raluca-timis/Proiect_Licenta/Documentatie.pdf

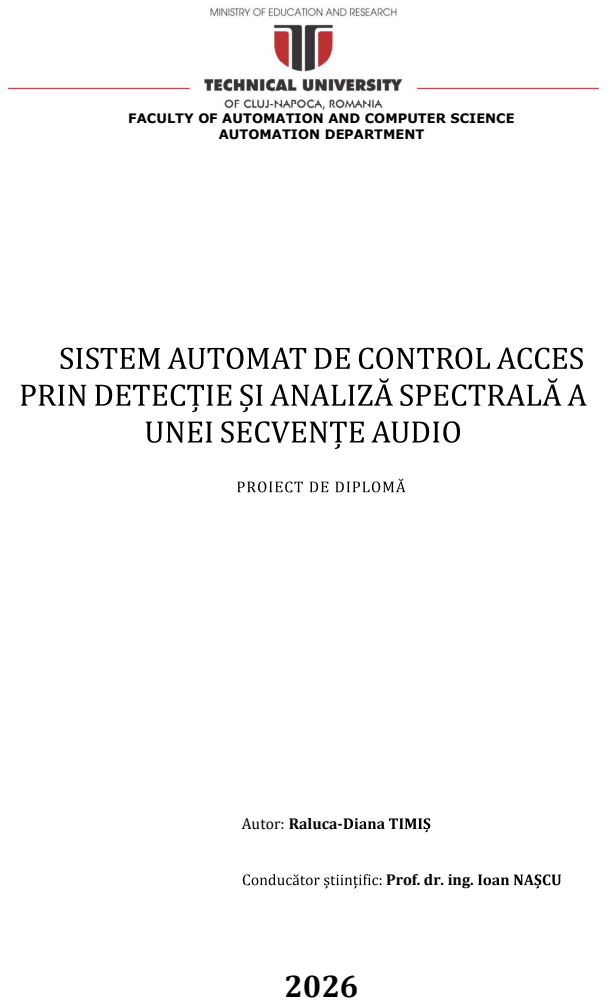
[picture p1: page 1]
AUTOMATION DEPARTMENT; Autor: Raluca-

FACULTY OF AUTOMATION AND COMPUTER SCIENCE

Prof. dr. ing.

# Cuprins

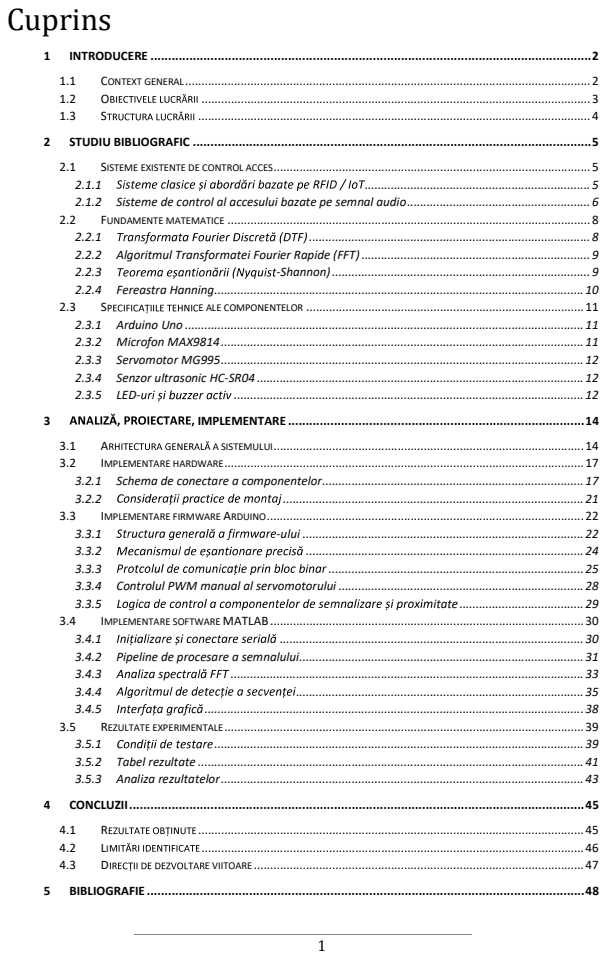
[picture p2: page 2]

Introducere

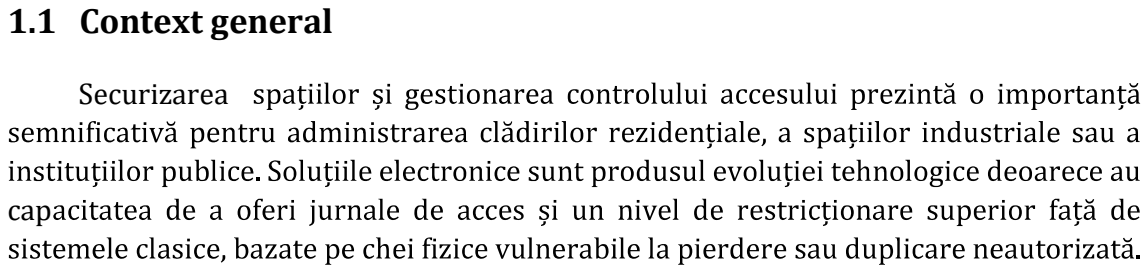
[picture p3: figure]
1.1 Context general; Securizarea; cap
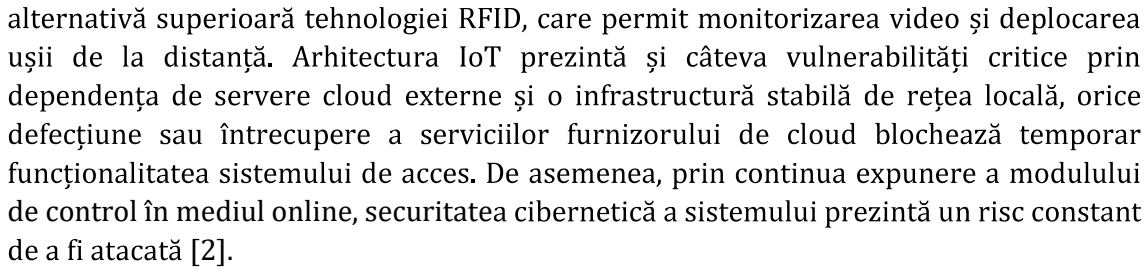
[picture p4: figure]
de control în mediul online, securitate [2].
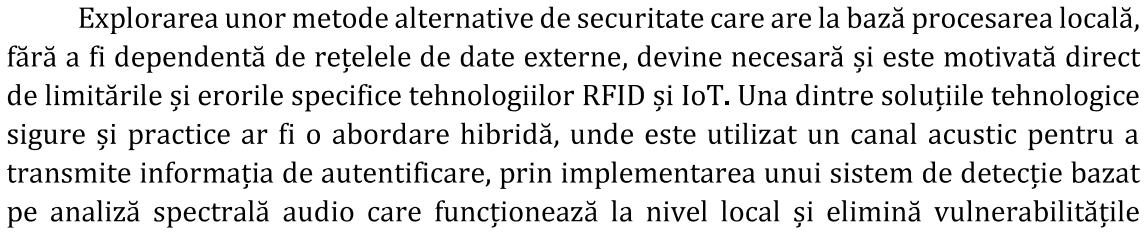
[picture p5: figure]

2

# 1 Introducere

electromagnetice provenite de la obiecte metalice, necriptarea cartelelelor care pot fi

[1]. A urmat integrarea sistemelor Internet of Things,

cauzate de posibilele atacuri cibernetice asociate de conexiunile la internet. Un alt avantaj solid al acest
folosind hardware aflat deja în posesia utilizatorilor, precum difuzoarele integrate ale

dedicate.

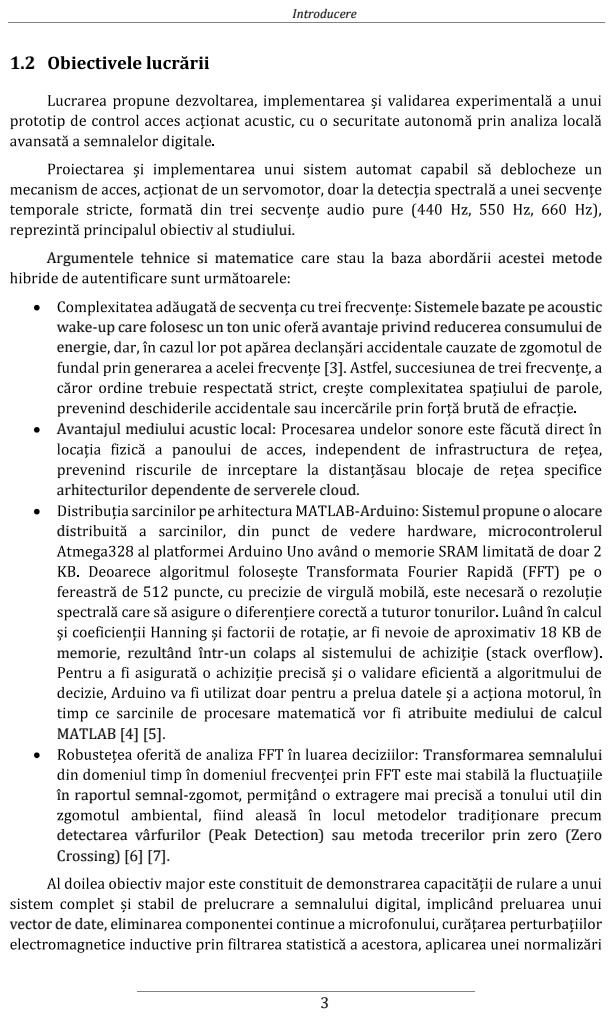
[picture p6: page 4]
Introducere; diului.; Argumentele tehnice si matematice; acestei metode; wake-up care folosesc un ton unic; avantaje privind reducerea consumului de; energie; dis; , microcontrolerul; MATLAB [4] [5].; Transformarea semnalului

Sistemele bazate pe acoustic

Avantajul mediului acustic local:

arhitecturilor dependente de serverele cloud.

-Arduino: Sistemul propune o alocare

memorie, rezultând într-un colaps al sis

atribuite mediului de calcul

în raportul semnal-

detectarea vârfurilor (Peak Detection) sau metoda trecerilor prin zero (Zero
Crossing) [6] [7].

vector de date, elimin

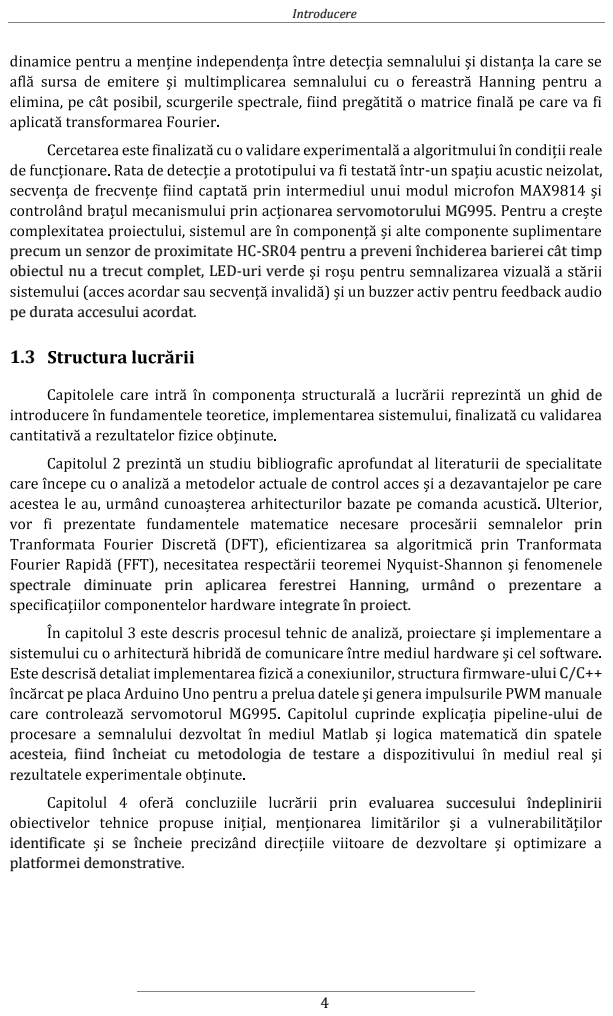
[picture p7: page 5]
Introducere; - a servomotorului MG995.; ghid de; -ului C/C++; -ului de; identificate; se încheie; platformei demonstrative.

precum un senzor de proximitate HC-SR04 pentru a preveni închiderea barierei cât timp
obiectul nu a trecut complet, LED-uri verde

pe durata accesului acordat.

prin - spectrale diminuate prin aplicarea ferestrei Hanning, urmând o prezentare a

egrate în proiect.

acesteia, fiind încheiat cu metodologia de testare
rez

aluarea succesului îndeplinirii

# 2 Studiu bibliografic

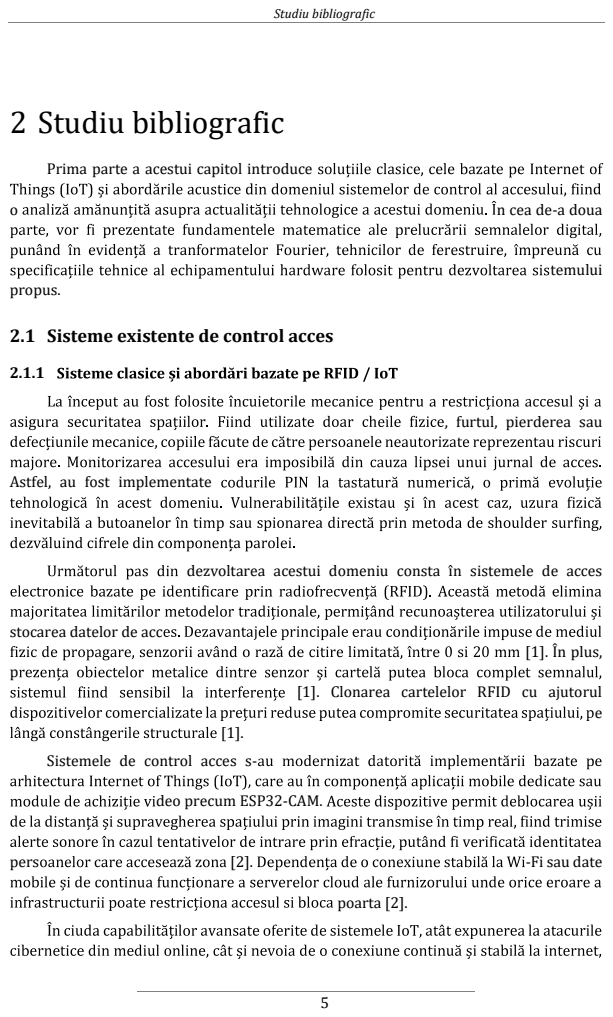
[picture p8: page 6]
Studiu bibliografic; n cea de-a doua; temului; propus.; [1]. În plus,; pers; -Fi sau date; poarta [2].

Prima parte a acestui capitol introduce

2.1 Sisteme existente de control acces

, furtul, pierderea sau

Astfel, au fost implementate

dezvoltarea acestui domeniu consta în sistemele de acces

stocarea datelor de acc

[1]. Clonarea cartelelor RFID cu ajutorul

Sistemele de control acces s-

deo precum ESP32-CAM.

Studiu bibliografic

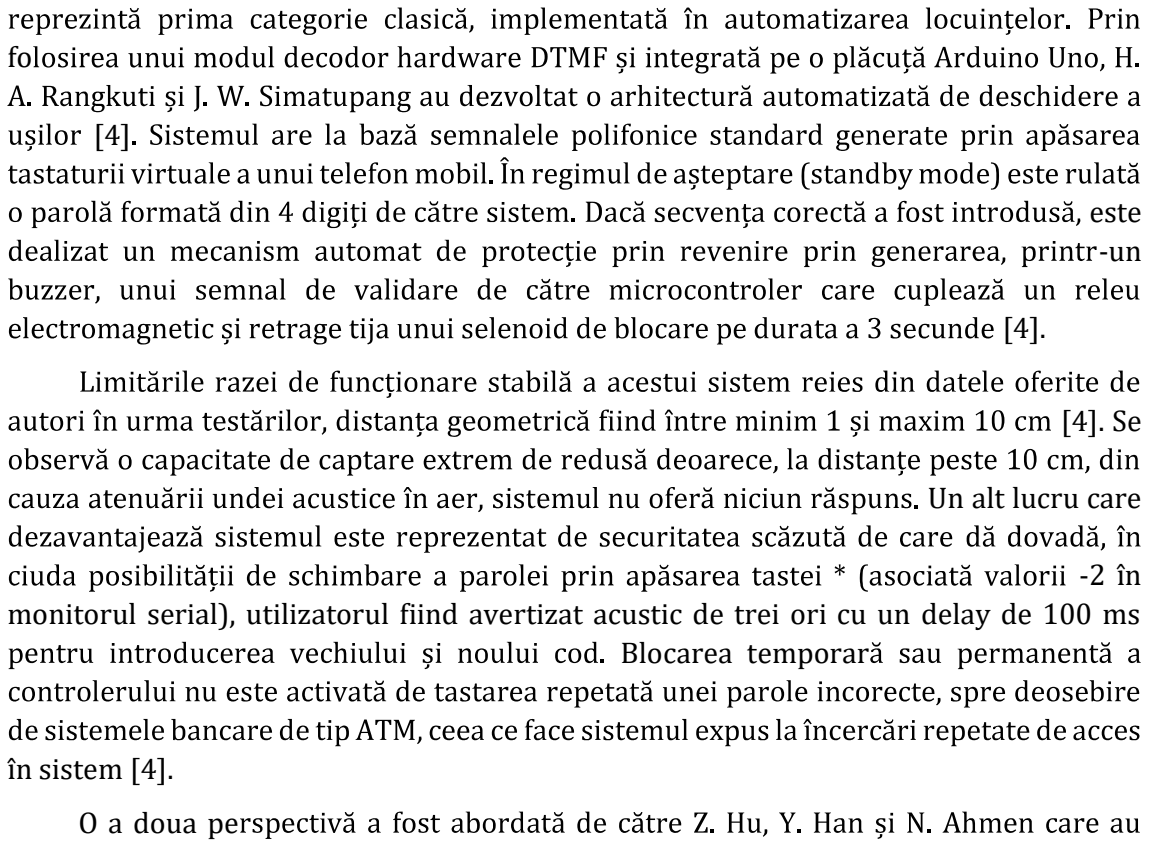
[picture p9: figure]
este -un; Un alt lucru care; Blocarea temporar; în sistem [4].; O a doua pe
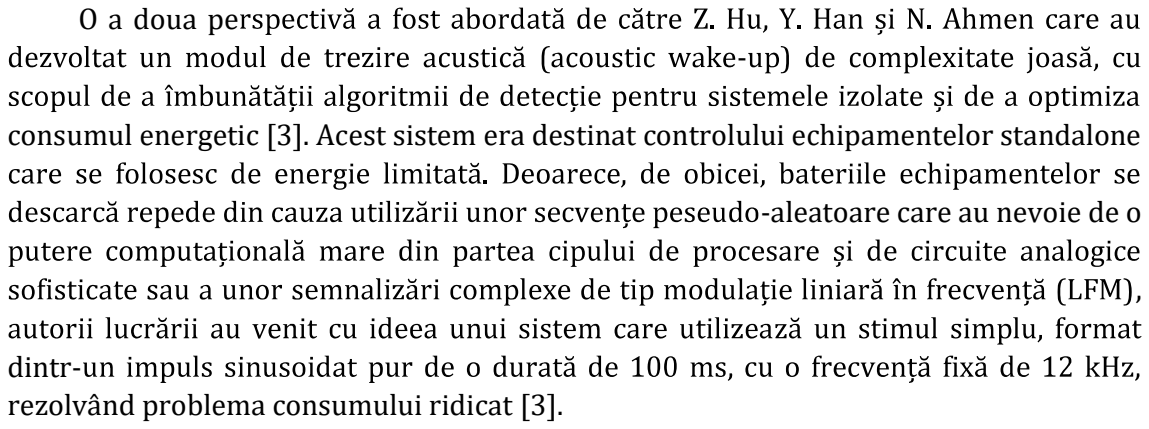
[picture p10: figure]
-aleatoare care au nevoie de o; , dintr-; rezolvând problema consumului ridicat [3].

6

### 2.1.2 Sisteme de control al accesului bazate pe semnal audio

hardware sau matematice sau dezavantaje de design, literatura de specialitate introduce trei mari categorii.
Sistemele de blocare bazate pe tehnologia DTMF (Dual-Tone Multi-Frequency)

monitorul serial), utilizatorul fiind avertizat acustic de trei ori cu un delay de 100 ms

- consumul energetic [3]. Acest sistem era destinat controlului echipamentelor standalone

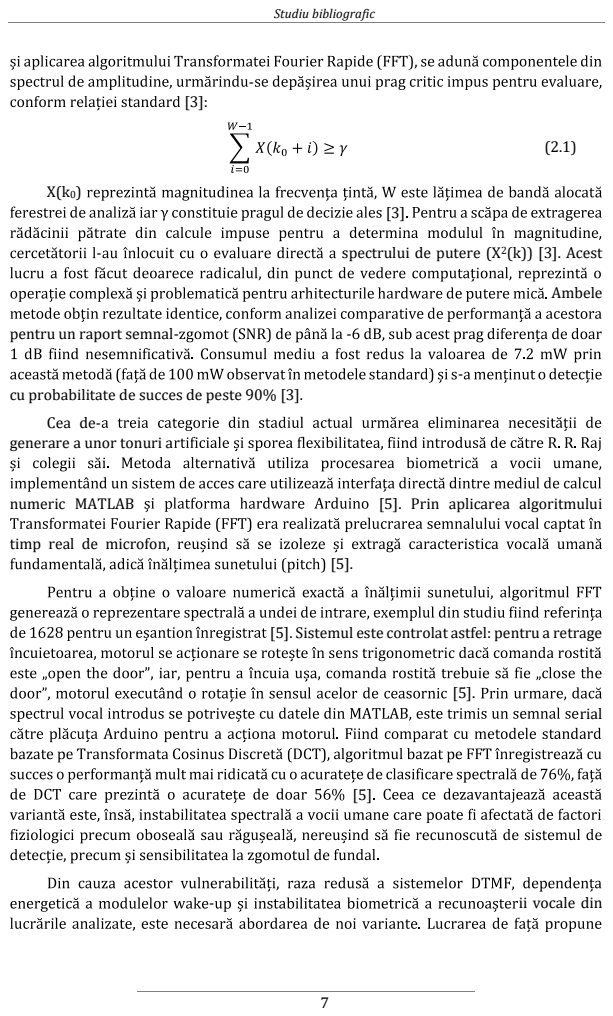
[picture p11: page 8]
Studiu bibliografic; Ambele; pentru un raport semnal-; numeric MATLAB; [5]. Prin aplicarea algoritmului; rial

- spectrului de putere (X²(k)) [3]. Acest

- cu probabilitate de succes de peste 90% [3].

Cea de-
generare a unor tonuri a

timp real de microfon

[5]. Sistemul este controlat astfel: pentru a retrage

- ii vocale din

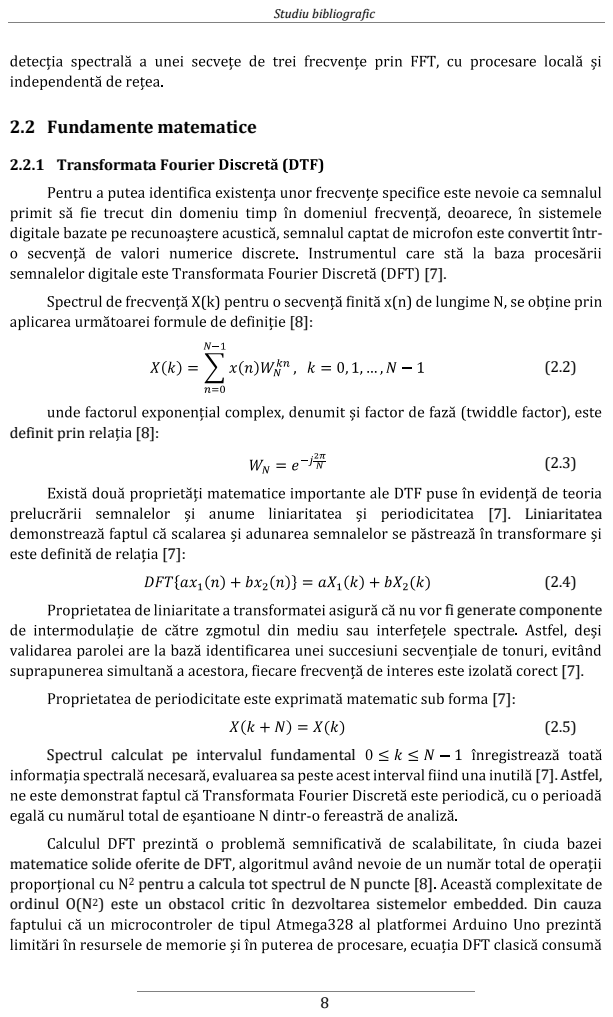
[picture p12: page 9]
Studiu bibliografic; 2.2 Fundamente matematice; 2.2.1 Transformata Fourier; definit prin rel; [7]. Liniaritatea

te convertit într-

fi generate componente

Spectrul calculat pe intervalul fundamental
[7]. Astfel, - matematice solide oferite de DFT

2 pentru a calcula tot spectrul de N puncte [8]

ordinul O(N²) este un obstacol critic în dezvoltarea sistemelor embedded. Din cauza

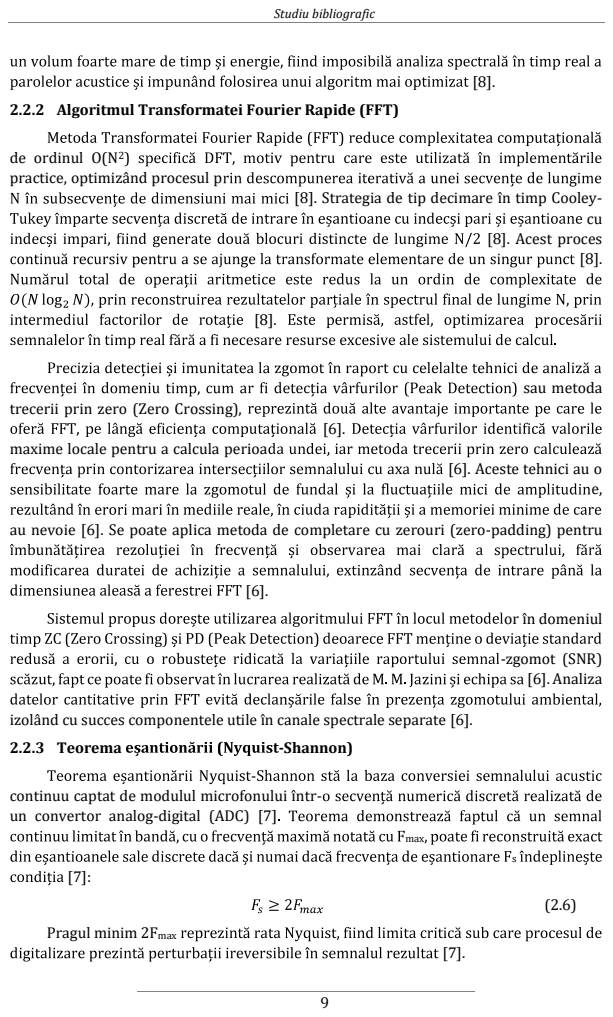
[picture p13: page 10]
Studiu bibliografic; cu [8]. Acest proces [8].; sau metoda; -zgomot (SNR) [6]. Analiza; 2.2.3 Teorema; -Shannon) - continuu captat de modulul microfonului într-; un convertor analog-digital (ADC) [7]; max; Pragul minim 2Fmax

2.2.2 Algoritmul Transformatei Fourier Rapide (FFT)

de ordinul O(N²
practice, optimizând procesul p

[8]. Strategia de tip decimare în timp Cooley-

trecerii prin zero (Zero Crossing),

maxime locale pentru a calcula perioa

[6]. Aceste tehnici au o

au nevoie [6]. Se poate aplica metoda de completare cu zerouri (zero-padding) pentru

or în domeniul

izolând cu succes componentele utile în canale spectrale separate [6].

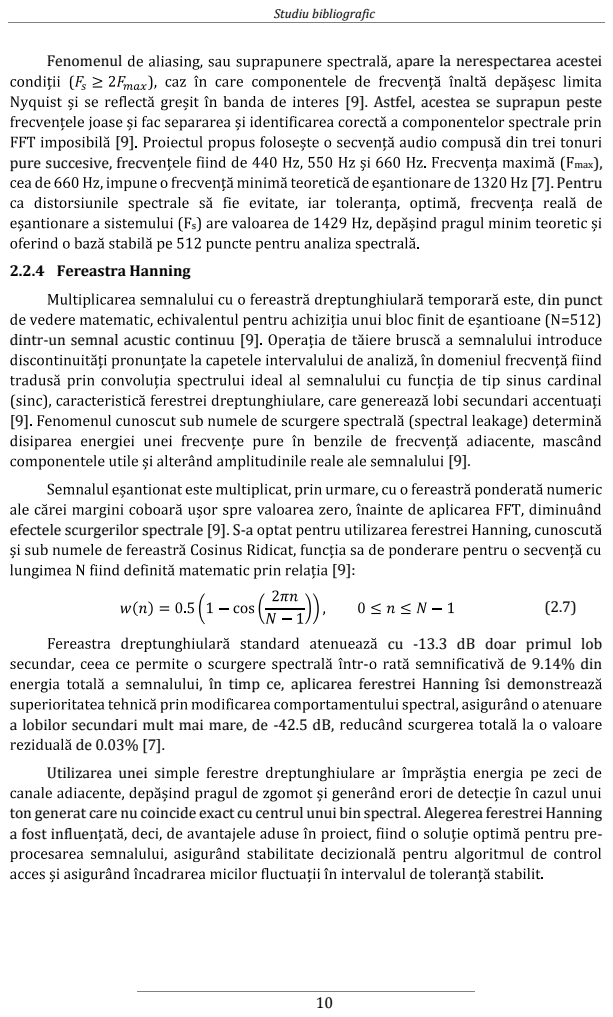
[picture p14: page 11]
Studiu bibliografic; Fenomenul; pare la nerespectarea acestei; pure succesive, frecve; max),; [7]. Pentru; frecve; s 2.2.4 Fereastra Hanning; in punct; cu -13.3 dB doar primul lob -; de 9.14% din; a fost influen

[9]. Astfel, acestea se suprapun peste

dintr-un semnal acustic continuu [9]

efectele scurgerilor spectrale [9]. S-a

, în timp ce, aplicarea ferestrei Hanning îsi demo

a lobilor secundari mult mai mare, de -42.5 dB,

Utilizarea unei si

ton generat care nu coincide exact cu centrul unui bin spectral. Alegerea ferestrei Hanning

Studiu bibliografic

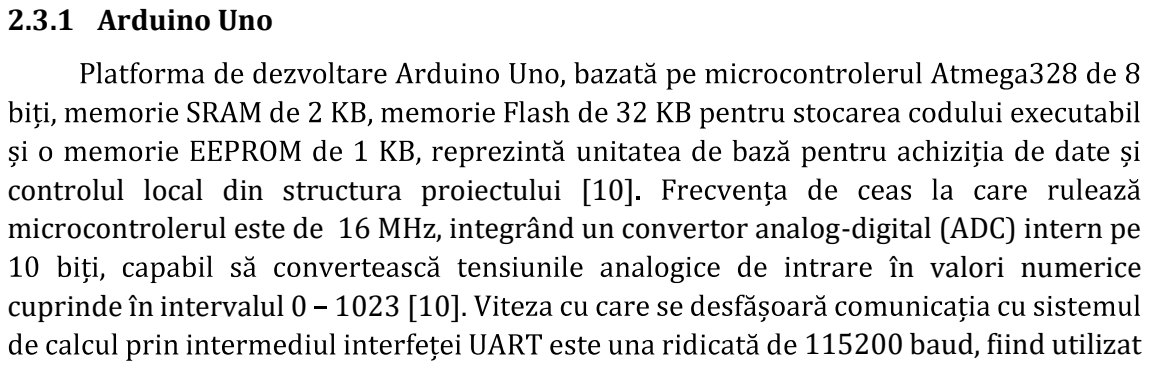
[picture p15: figure]
2.3.1 Arduino Uno; în valori numerice; cuprinde în intervalul 0 1023 [10].; 115200 baud, fiind utilizat
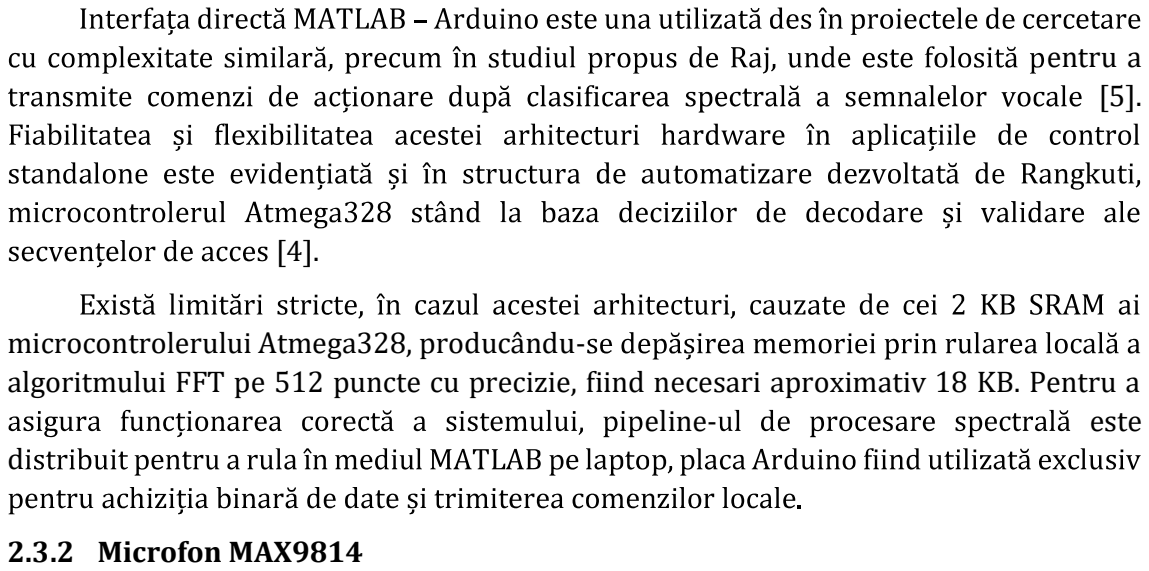
[picture p16: figure]
entru a [5].; microcontrolerului Atmega328, producându-; eline-; este; 2.3.2 Microfon MAX9814
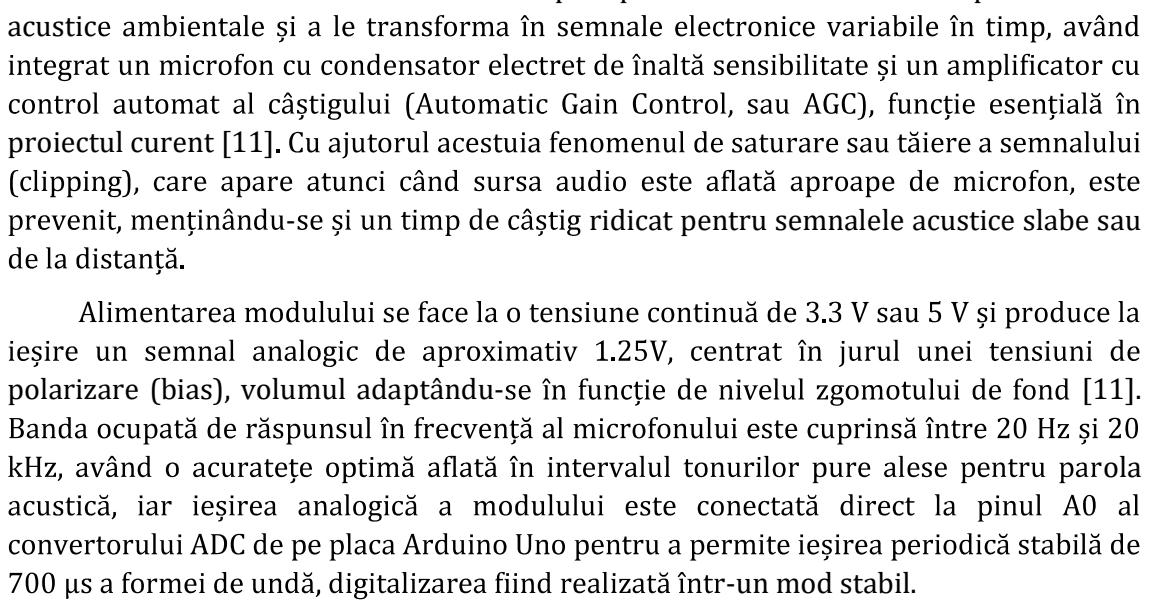
[picture p17: figure]
acustic; proiectul curent [11]; polarizare (bias), volumul adaptându-; ola; -un mod stabil.

11

### 2.3 Specif

controlul local din structura proiectului [10]
microcontrolerul este de 16 MHz, integrând un convertor analog-digital (ADC) intern pe

un protocol de transmisie în bloc binar prin markeri specifici.

algoritmului FFT pe 512 puncte cu precizie, fiind necesari aproximativ 18 KB. Pentru a

Rolul modulului de microfon bazat pe cipul MAX9814 este de a capta a undele

- ridicat pentru semnalele acustice slabe sau

Studiu bibliografic

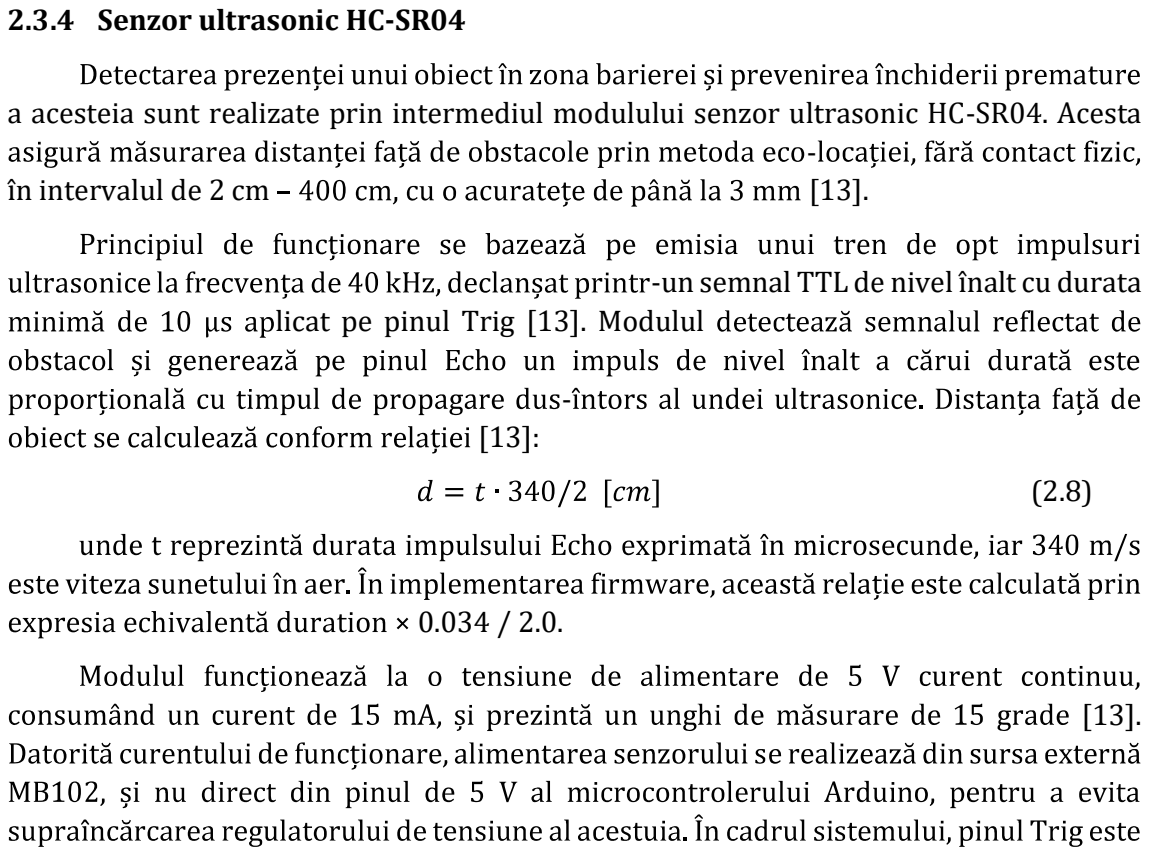
[picture p18: figure]
2.3.4 Senzor ultrasonic HC-SR04; în intervalul de 2 cm; -un semnal TTL de nivel înalt cu durata licat pe pinul Trig [13]. Modulul -

12

### 2.3.3 Servomotor MG995

Caracteristicile principale ale servomotorului de mare cuplu model MG995 care se

ocare la primirea unei parole audio corecte.

sincronizare direct din codul microcontrolerului Arduino, fiind trimis un tren de 50 de pulsuri compuse dintrde 19000 µs. Controlul manual al servomoto
ale
în contact cu magistrala URAT, fiind evitat i un algoritm de control bazat pe un model matematic explicit. Prin urmare, servomotorul este

a acesteia sunt realizate prin intermediul modulului senzor ultrasonic HC-SR04. Acesta -

conectat la pinul digital 5, iar pinul Echo la pinul digital 6 al platformei Arduino Uno.

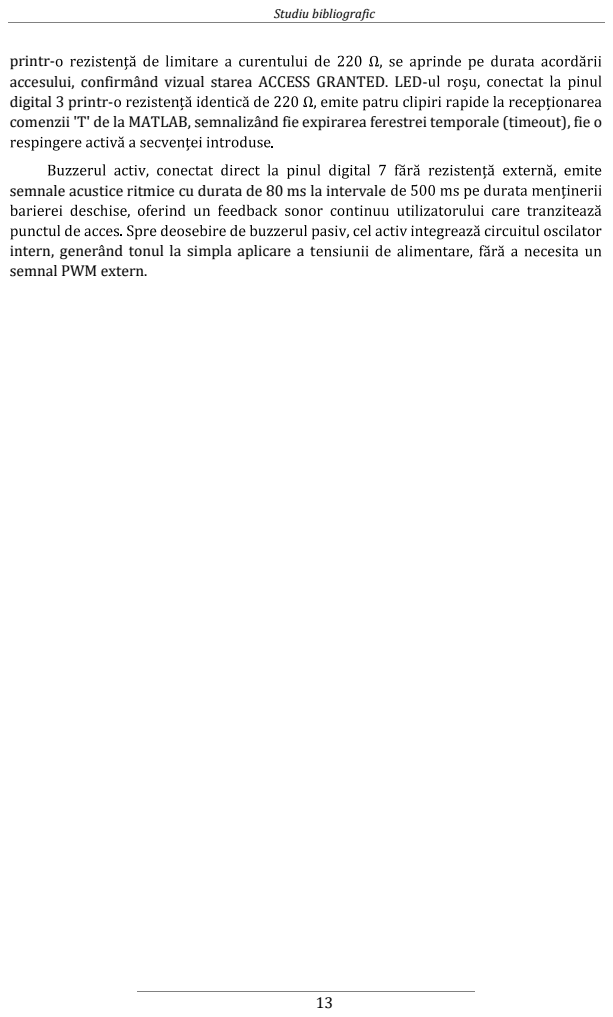
[picture p19: page 14]
Studiu bibliografic

printr-
accesului, confirmând vizual starea ACCESS GRANTED. LED-
digital 3 printr-
comenzii 'T' de la MATLAB, semnalizând fie expirarea ferestrei temporale (timeout), fie o

semnale acustice ritmice cu durata de 80 ms la intervale

intern, generând tonul la simpla aplicare a t
semnal PWM extern.

3

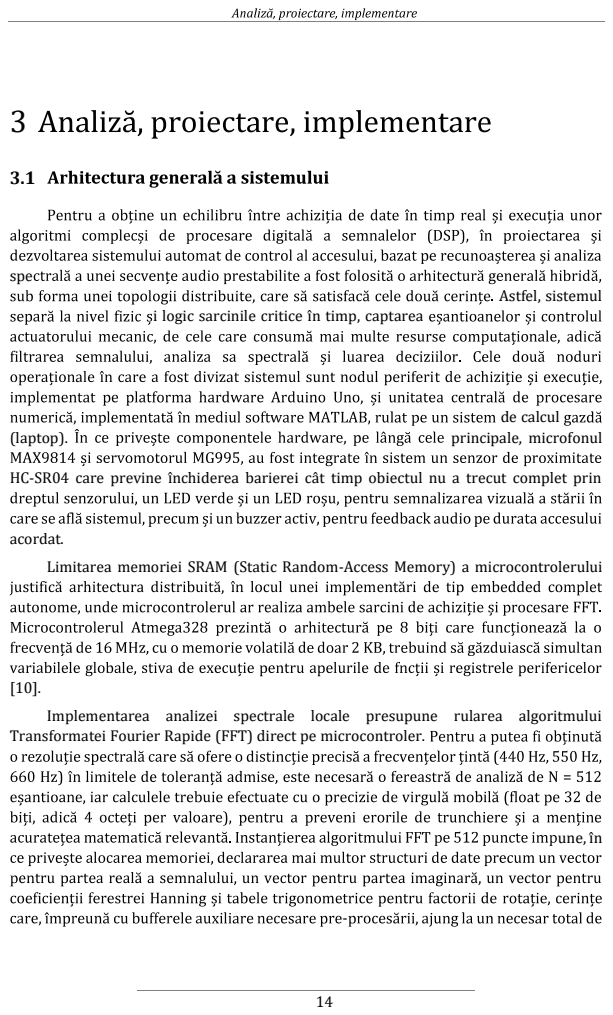
[picture p20: page 15]
spe; Astfel, sistemul; de calcul; (laptop).; principale, microfonul; une, în -

i logic sarcinile critice în timp, captarea

HC-SR04 care previne închiderea barierei cât timp obiectul nu a trecut complet prin

acordat.
Limitarea memoriei SRAM (Static Random-Access Memory) a microcontrolerului

Implementarea analizei spectrale locale presupune rularea algoritmului
Transformatei Fourier Rapide (FFT) direct pe microcontroler.

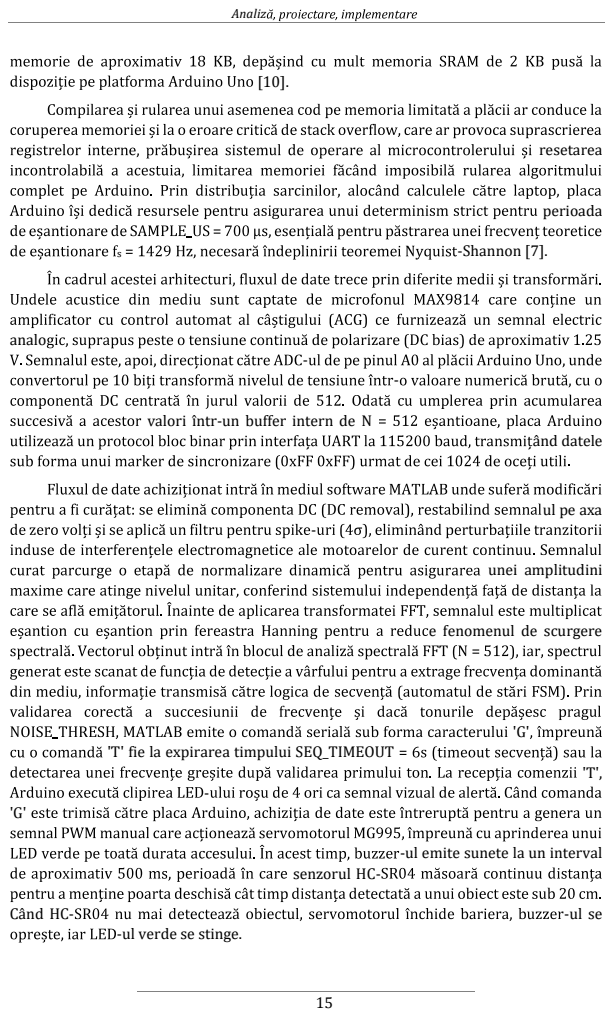
[picture p21: page 16]
Analiz; resetarea; perioada s; -Shannon [7].; analo; ând datele; unei amplitudini; senzorul HC-; Când HC-

valori într-un buffer intern de N

ul pe axa -

e fenomenul de scurgere

'T' fie la expirarea timpului SEQ_TIMEOUT

-ul emite sunete la un interval

-ul verde se stinge.

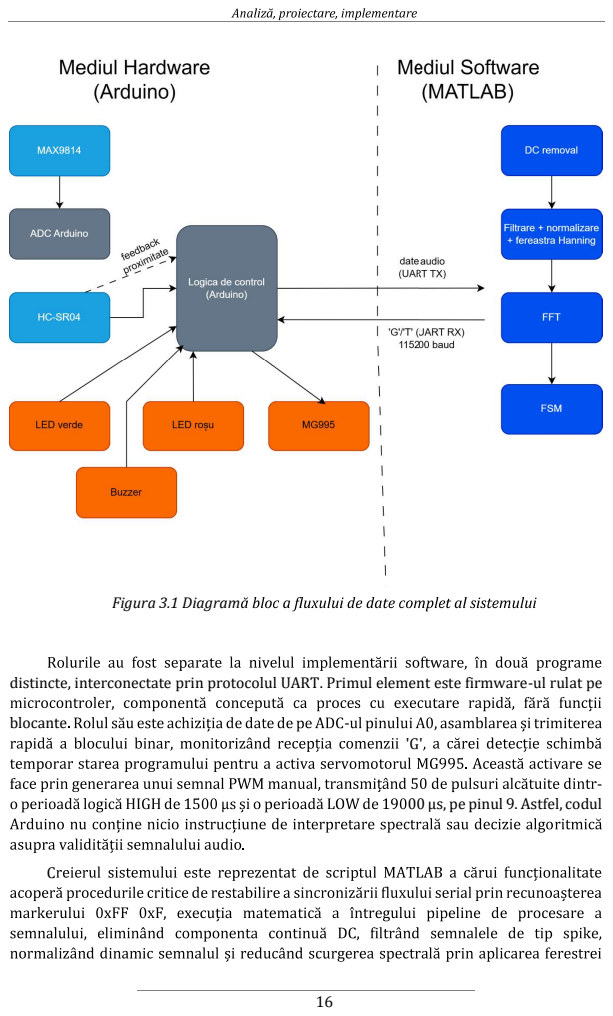
[picture p22: page 17]
blocante; - 00 µs, pe pinul 9. Astfel, codul; Figura 3.1 Diagram

distincte, interconectate prin protocolul UART. Primul element este firmware-ul rulat pe

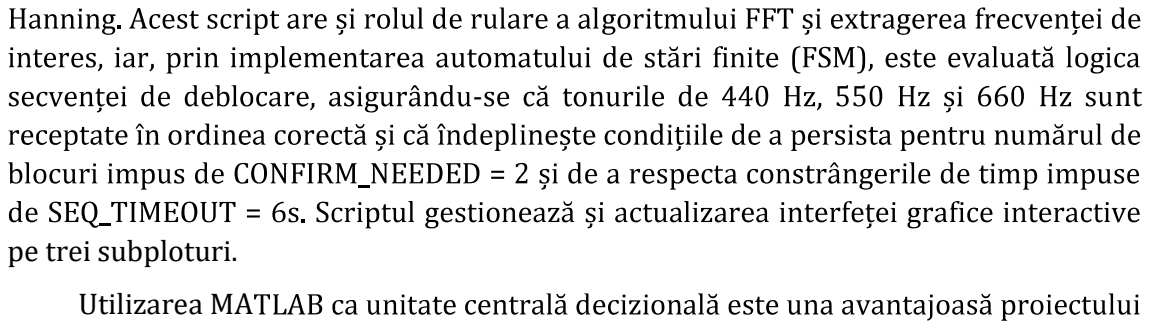
[picture p23: figure]
pe trei subploturi.; Utilizarea MA
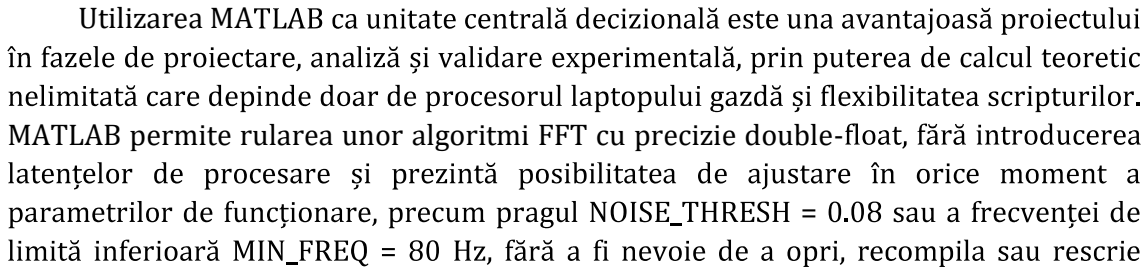
[picture p24: figure]
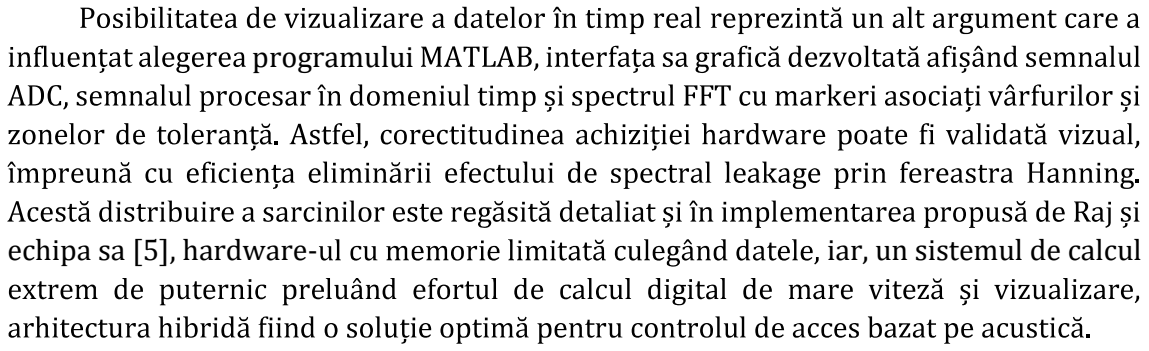
[picture p25: figure]
programului; echipa sa [5], hardware-; iar, un sistemul de calcul
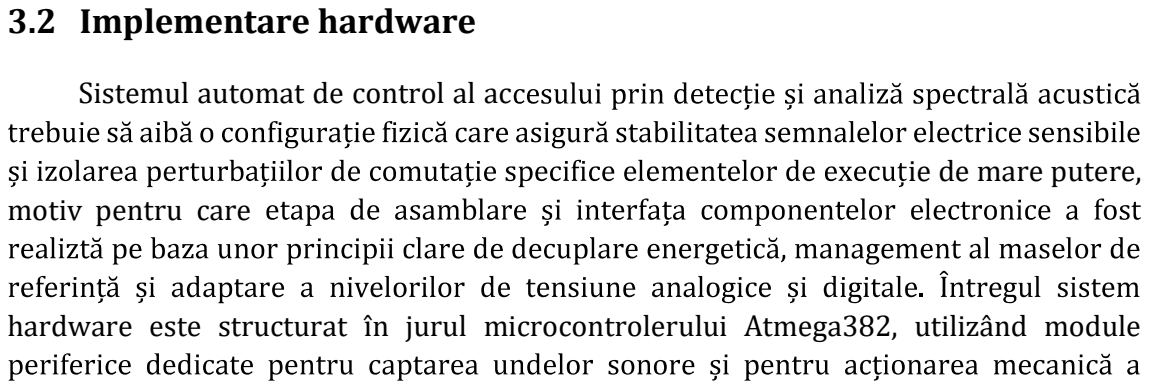
[picture p26: figure]
3.2 Implementare hardware; Sistemul automat de control al ac; ie de mare putere,; motiv pentru care

17

MATLAB permite rularea unor algoritmi FFT cu precizie double-

memoria Flash a microcontrolerului pentru fiecare calibrare.

hardware este structurat în jurul microcontrolerului Atmega382, utilizând module

barierei de acces, conectate direct cu un sistem de calcul numeric prin intermediul unei conexiuni seriale.

### 3.2.1 Schema de conectare a componentelor

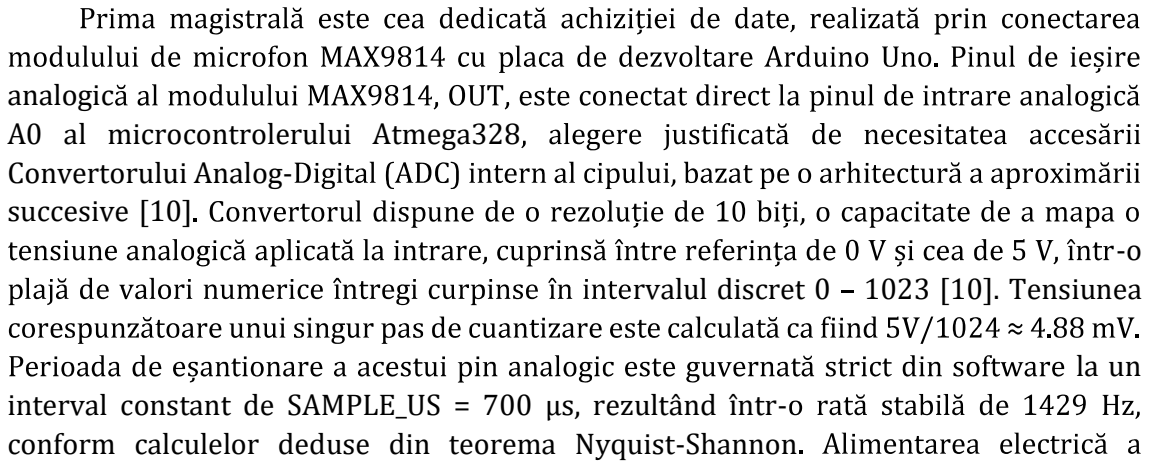
[picture p27: figure]
analogic A0 al microcontrolerului Atmega328 Convertorului Analog- succesive [10]; -o rvalul discret 0 1023 [10]. Tensiunea
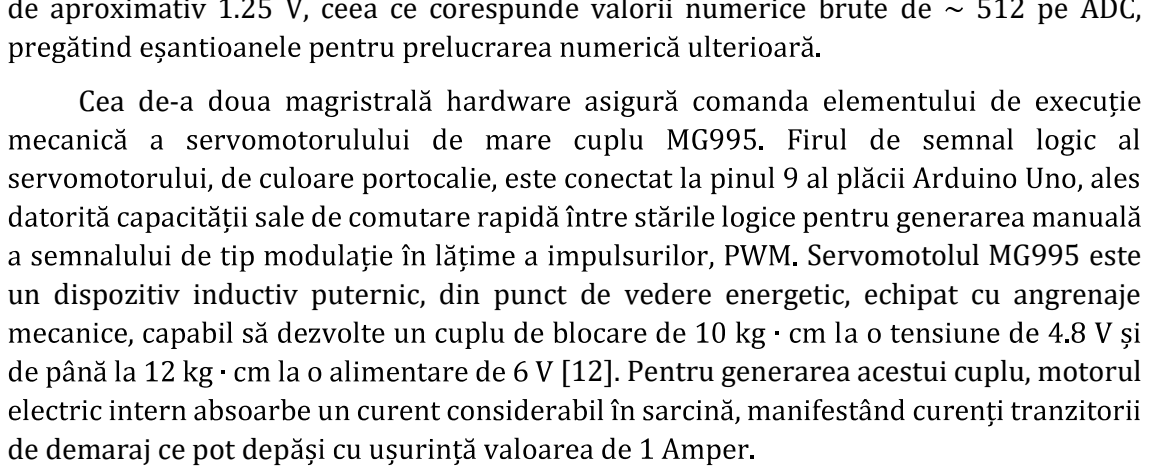
[picture p28: figure]
Cea de-; Servomotolul MG995 este; de demaraj ce pot dep

18

interval constant de SAMPLE_US = 700 µs, rezultând întrconform calculelor deduse din teorema Nyquist-Shannon

Integrarea cipului MAX9814 în acest punct
iei sale i | | Automatic Gain Control).
invers p | ei fa | a unui etaj
utilizatorul ar reda | | , semnalul ar
| | (clipping),
care | | -o într-
ie. Invers, da | - | mare, de exemplu
50 cm, semnalul ar fi prea slab, fiind înecat în zgomotul de cuantizare al ADC-ului. Circuitul

tigul pentru semnalele acustice de intensitate

ire în intervalul optim de conversie al ADC-ului, | [11].
Semnalul util furnizat este centrat în jurul unei tensiuni continue de polarizare (DC bias) de aproximativ 1.25 V, ceea ce corespunde valorii numerice brute de 512 pe ADC,

un dispozitiv inductiv puternic, din punct de vedere energetic, echipat cu angrenaje

[12]. Pentru generarea acestui cuplu, motorul

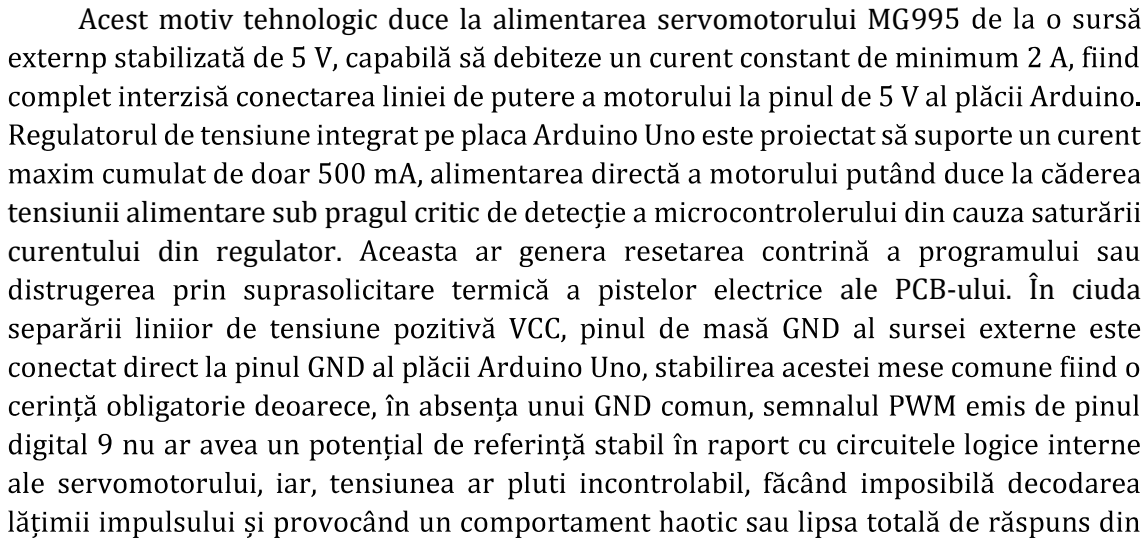
[picture p29: figure]
tensiunii alimentare sub pragul critic curentului din regulator.; ale PCB-ului. În ciuda
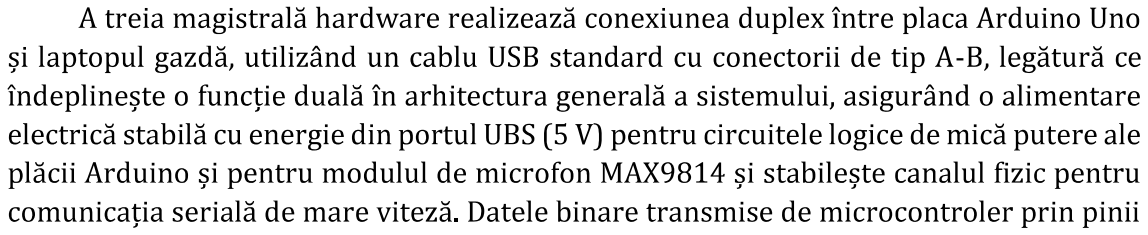
[picture p30: figure]
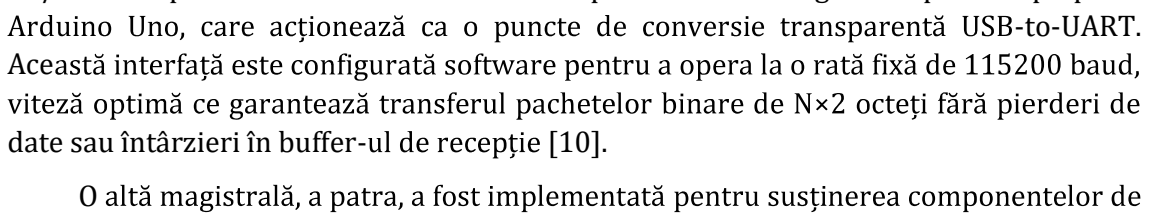
[picture p31: figure]
-to-UART.; Ace; date sau întârzieri în buffer-
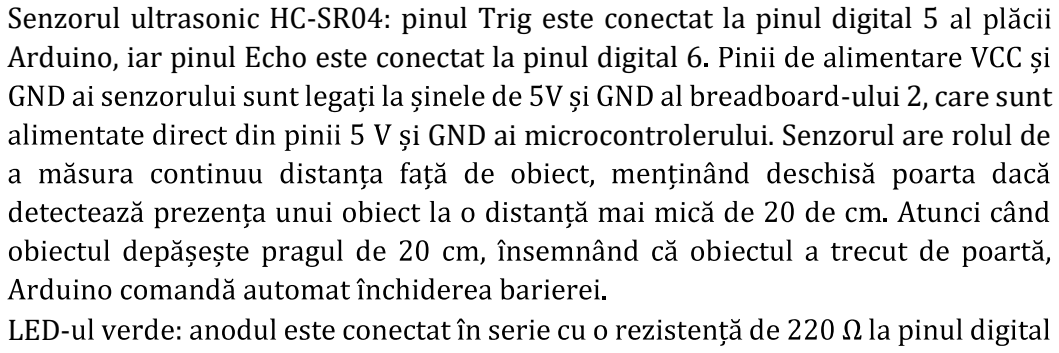
[picture p32: figure]
-ului 2, care sunt; LED-

19

Acest motiv tehnologic duce la alimentarea servomotorului MG99

partea actuatorului [10] [12]. | - TX/RX sunt preluate la nivel hardware de cipul dedicat Atmega16U2 prezent pe placa

Senzorul ultrasonic HC-SR04: pinul Trig este conectat la pinul digital 5 Arduino, iar pinul Echo este conectat la pinul digital 6

i GND ai microcontrolerului. Senzorul are rolul de

acordarea acce | 'G' de la mediul
MATLAB.
LED-

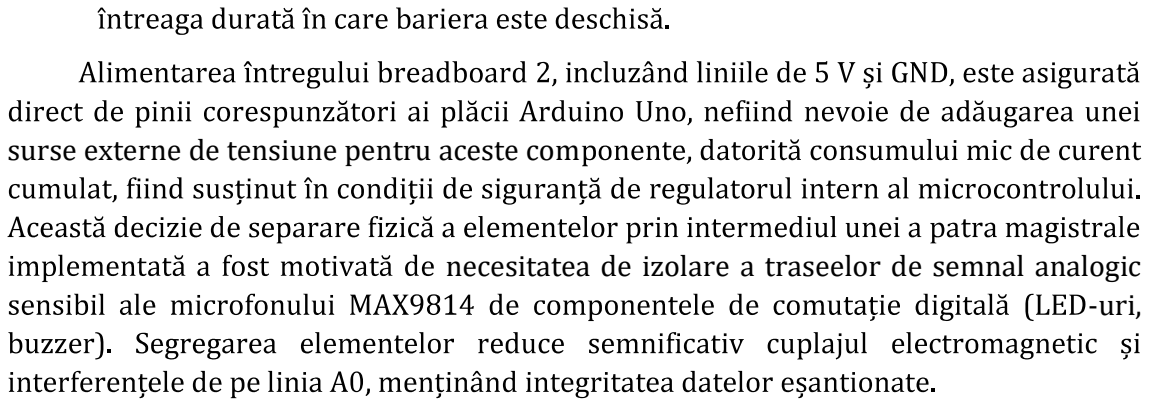
[picture p33: figure]
-uri,
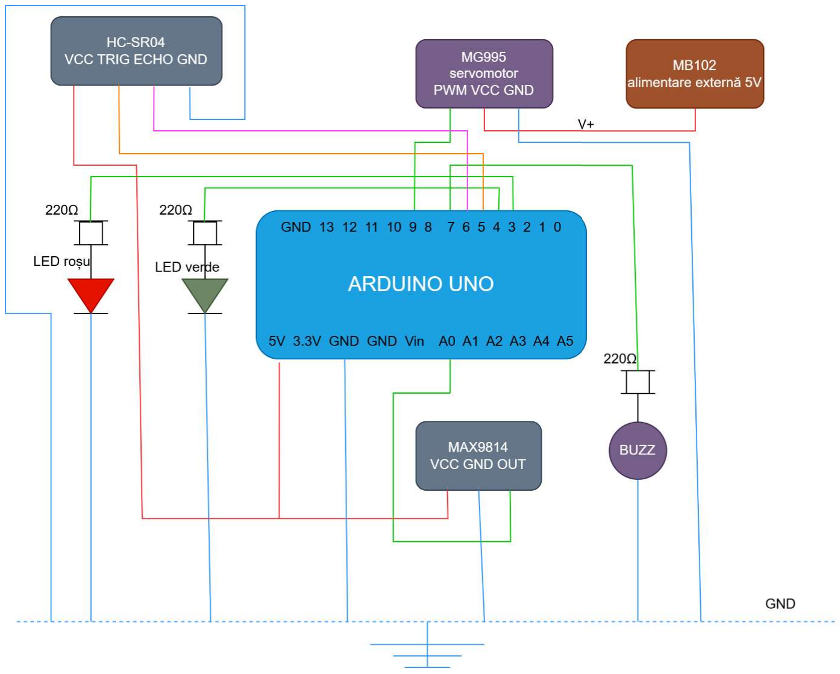
[picture p34: figure]

20

'T'.
Buzzer-ul activ: terminalul pozitiv (+) est | este
conectat la pinul digital 7, terminalul negativ fiind conectat la GND. Dispozitivul emite semnale acustice ritmice, bipuri, la un interval de aproximativ 500 ms, pe

surse externe de tensiune pentru aceste com

necesitatea de izolare a traseelor de semnal analogic

Figura 3.2

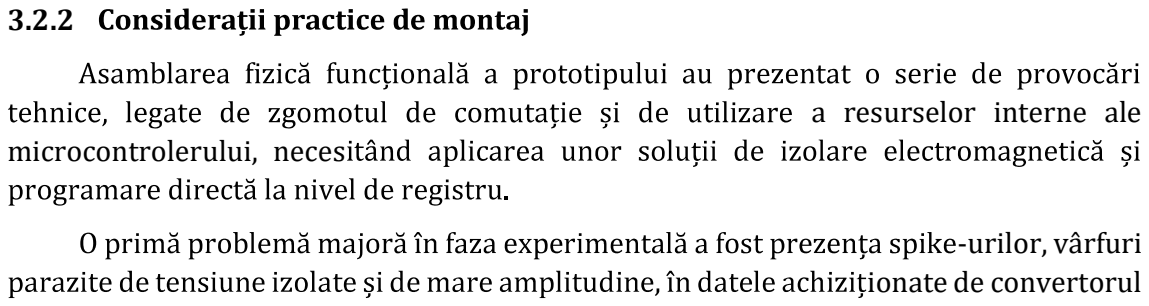
[picture p35: figure]
a resurselor interne ale; microcontrolerului, neces; -urilor, vârfuri ionate de convertorul
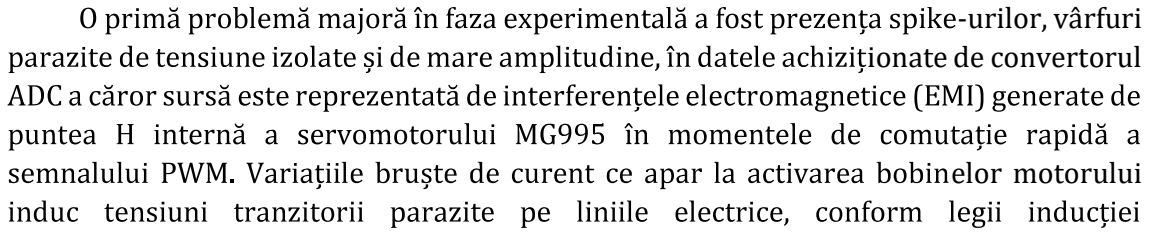
[picture p36: figure]
elor motorului
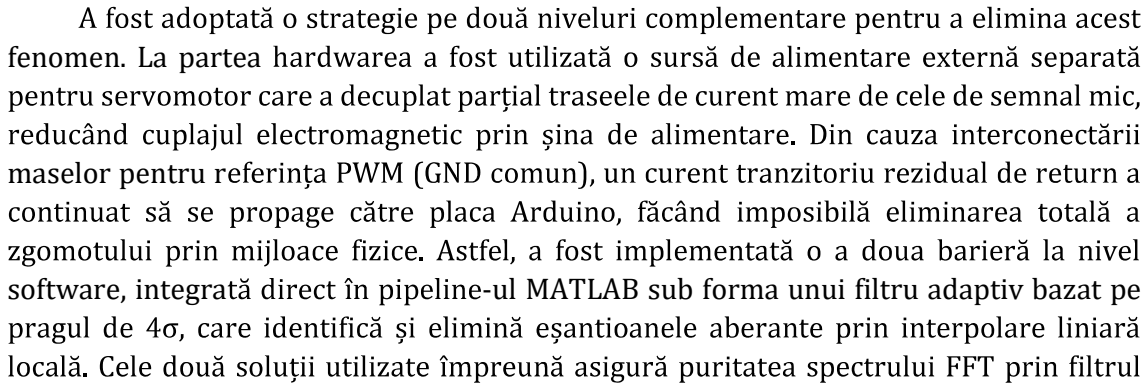
[picture p37: figure]
fenomen. La partea; maselor pentru r
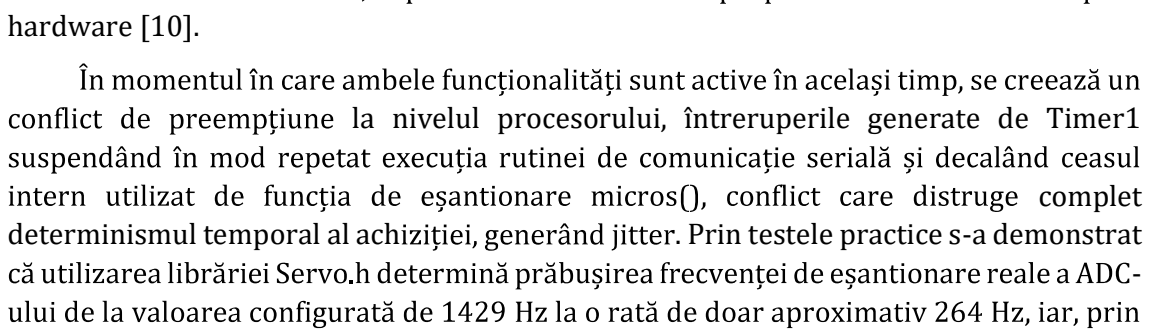
[picture p38: figure]
hardware [10].; complet

21

electromagnetice a lui Faraday, fenomen vizibil direct în mediul MATLAB pe graficul re atingeau
capetele scalei de cuantizare (0 sau 1023), distorsionând analiza Fourier prin
software, integra | -ul MATLAB sub forma unui filtru adaptiv bazat pe

implementat pe software, eliminând complet spike-urile reziduale din buffer, iar partea

[10] [12].

Timer1 al microcontrolerului Atmega328 pentru generarea semnalelor PWM în fundal, bazându-se pe întreruperi software de mare prioritate (Interrupt Service Routines sau
ISR) | - | or binare de

la nivelul procesorului, întreruperile generate de Timer1

determinismul temporal al ach | . Prin testele practice s-a demonstrat -

re, implementare

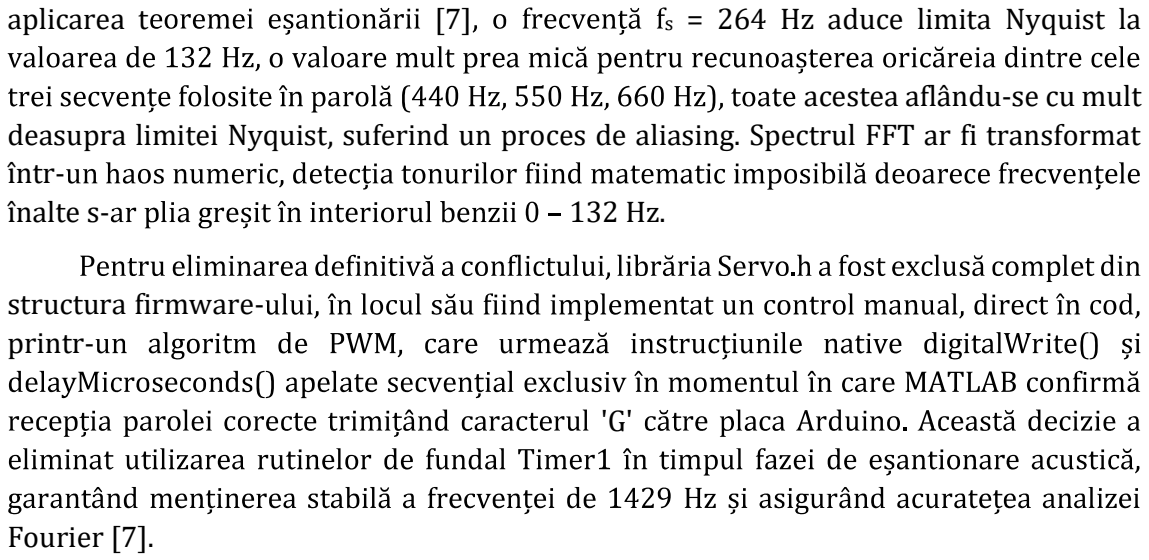
[picture p39: figure]
acestea aflându-se cu mult; într-; înalte s-; structura firmware- printr-; Fourier [7].
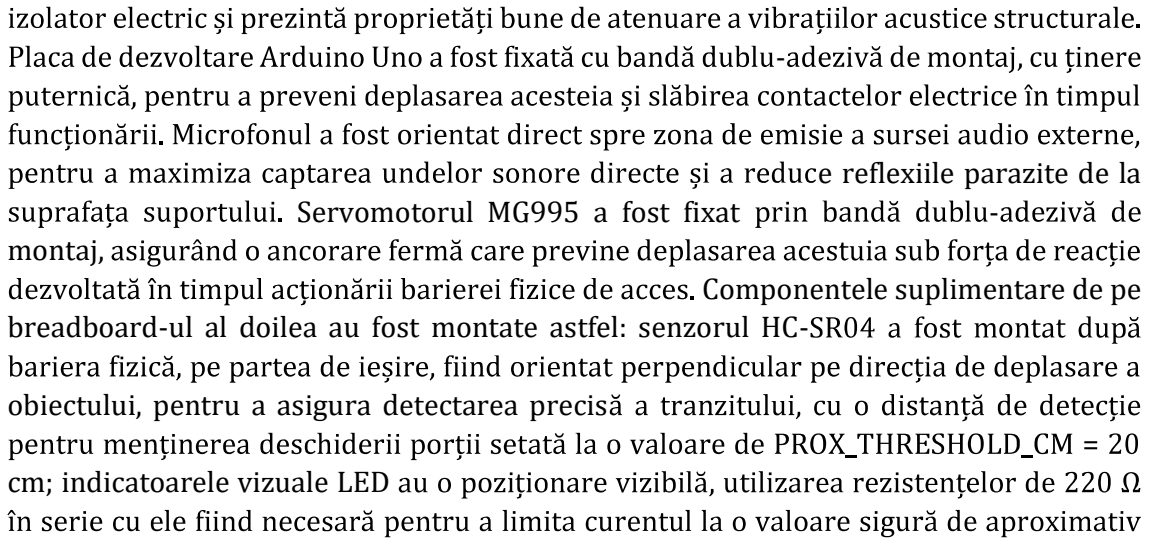
[picture p40: figure]
Servomotorul MG995 a fost fixat; - montaj,; Componentele suplimentare de pe; cm; indicatoarele vizuale LED
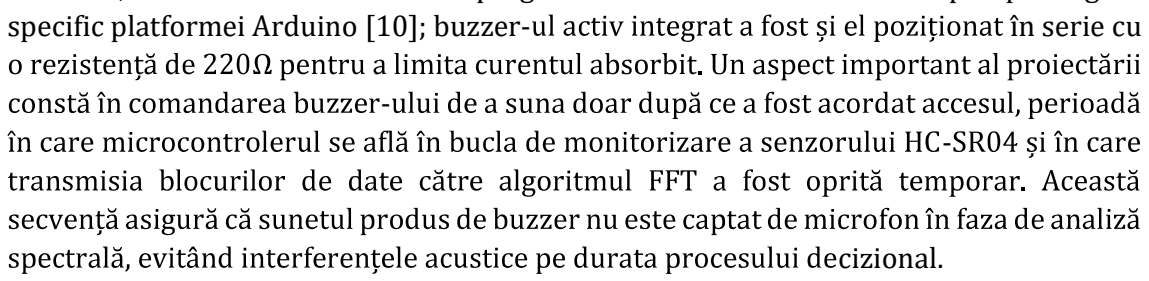
[picture p41: figure]
specific platformei Arduino [10]; buzzer-; în serie cu -; - cizional.

22

aplicarea t | [7] | s = 264 Hz aduce limita Nyquist la

deasupra limitei Nyquist, suferind un proces de aliasing. Spectrul FFT ar fi transformat

Montajul componentelor a fost plasat pe un placaj de lemn, deoarece acesta este un - e reflexiile parazite de la

breadboard-ul al doilea au fost montate astfel: senzorul HC-

obiectului, pentru a asigura detectarea precis

### 13.2 mA, încadrându-se astfel sub pragul maxim admisibil de 40 mA per pin digital

### 3.3 Implementare firmware Arduino

3.3.1 -ului
Software-ul executat de microcontrolerul Atmega328 pe platforma Arduino Uno are

e

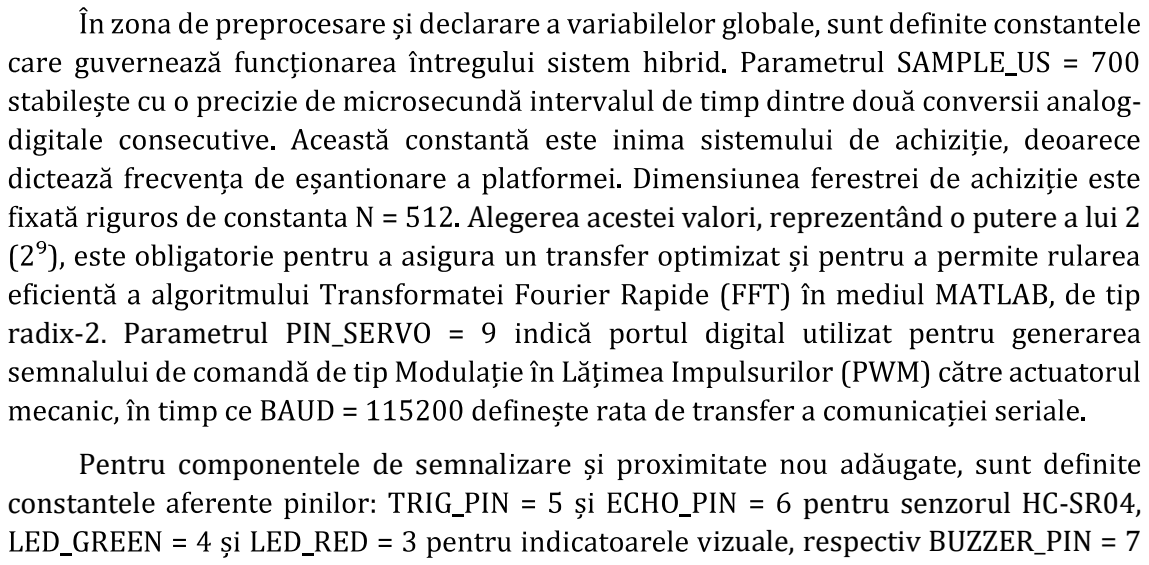
[picture p42: figure]
radix-2. Parametrul PIN_SE; Pentru componentele de semnal; constantel; pentru senzorul HC-SR04,; izuale, respectiv BUZZER_PIN = 7
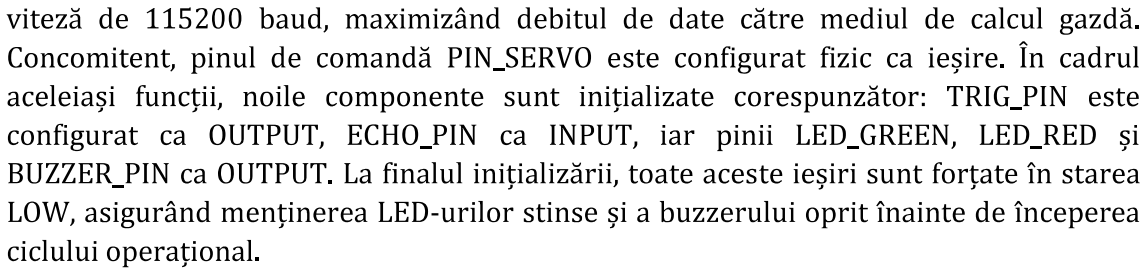
[picture p43: figure]
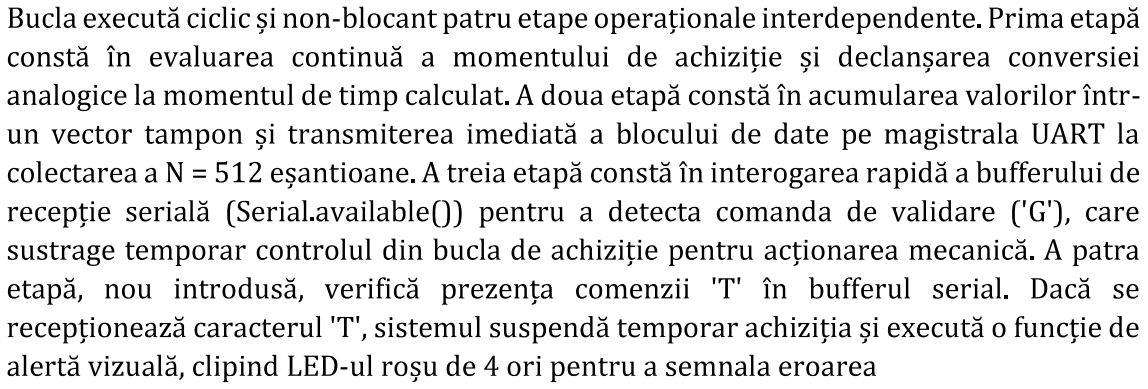
[picture p44: figure]

23

- Alegerea acestei valori, reprezentând o putere a lui 2

a fost definit pragul PROX_THRESHOLD_CM = 20,

alimentare sau la resetarea microc
Serial.begin(115200) pentru a configura hardware-ul UART intern al ATmega328 la o
- simplificate bazate pe un mec

sistemelor de operare în timp real (RTOS) care ar introduce un overhead nejustificat. -

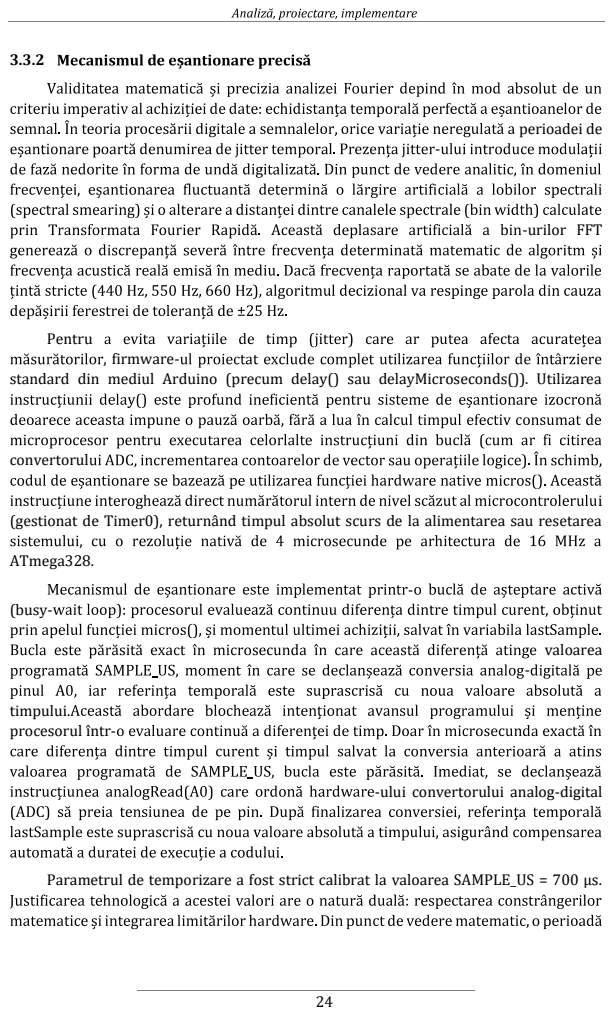
[picture p45: page 25]
perioadei de -; -urilor FFT; Pentru; , firmware-; convertorul; ATmega328.; - (busy-; valoarea - timpului.; procesorul într-

standard din mediul Arduino (precum delay() sau delayMicroseconds()). Utilizarea

(gestionat de Timer0), returnând timpul absolut scurs de la alimentarea sau resetarea

-ului convertorului analog-digital

Parametrul de temporizare a fost strict calibrat la valoarea SAMPLE_US = 700 µs.

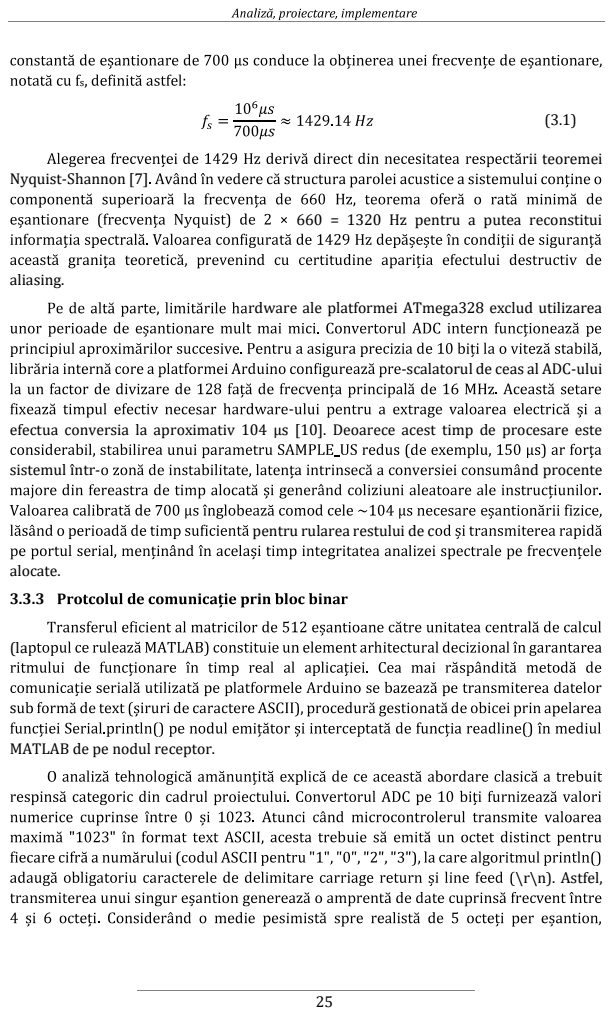
[picture p46: page 26]
ii teoremei; Nyquist-Shannon [7]; aliasing.; sistemul într-; nd procente; alocate.; \r\n). Astfel,

660 = 1320 Hz pentru a putea reconstitui

rdware ale platformei ATmega328 exclud utilizarea

-scalatorul de ceas al ADC-ului - efectua conversia la aproximativ 104 µs [10]. Deoarece acest timp de procesare este

pentru rularea restului de c

MATLAB de pe nodul receptor.

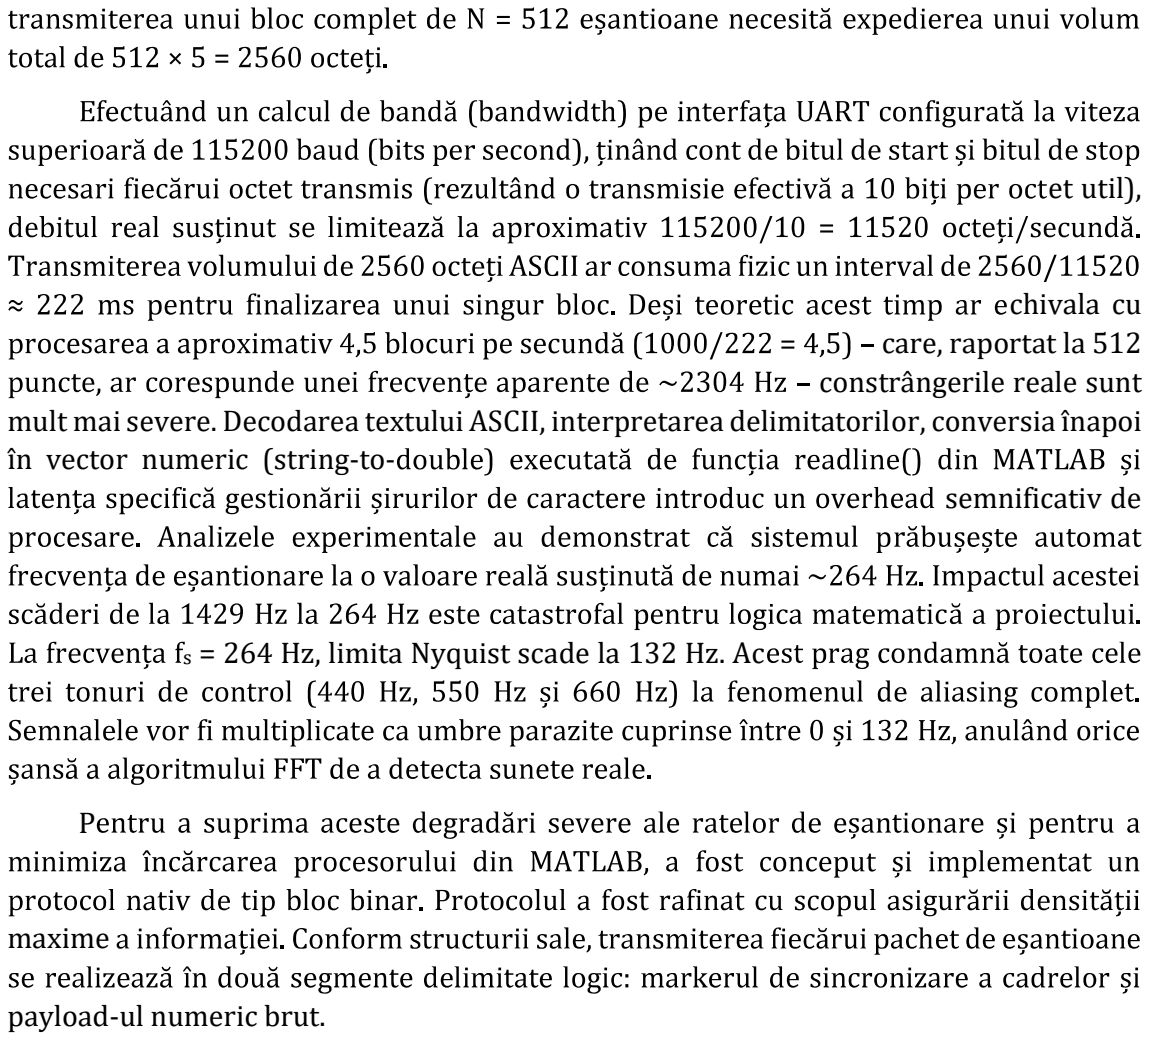
[picture p47: figure]
et util),; chivala cu care, raportat la 512 constrângerile reale sunt; în vector numeric (string-to-; maxime; payload-ul numeric brut.
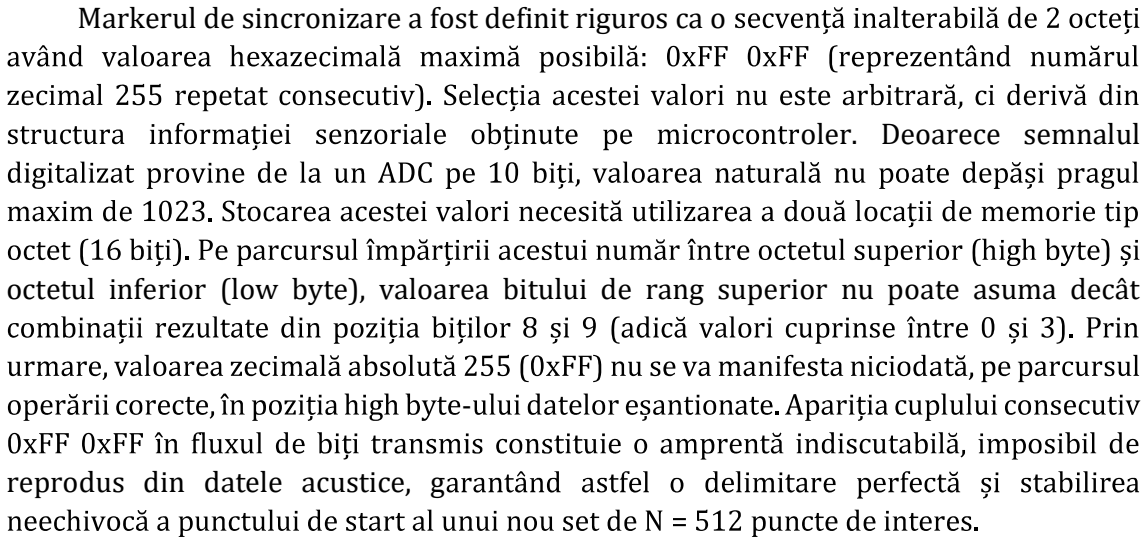
[picture p48: figure]
oler. Deoarece semnalul

26

mult mai severe. Decodarea textului ASCII, interpretarea delimitatorilor, conversia înapoi

semnificativ de s = 264 Hz, limita Nyquist scade la 132 Hz. Ac

Markerul de sincronizare a fost definit riguros ca o

octetul inferior (low byte), valoarea bitului de rang superior nu poate asuma decât - reprodus din datele acustice, g

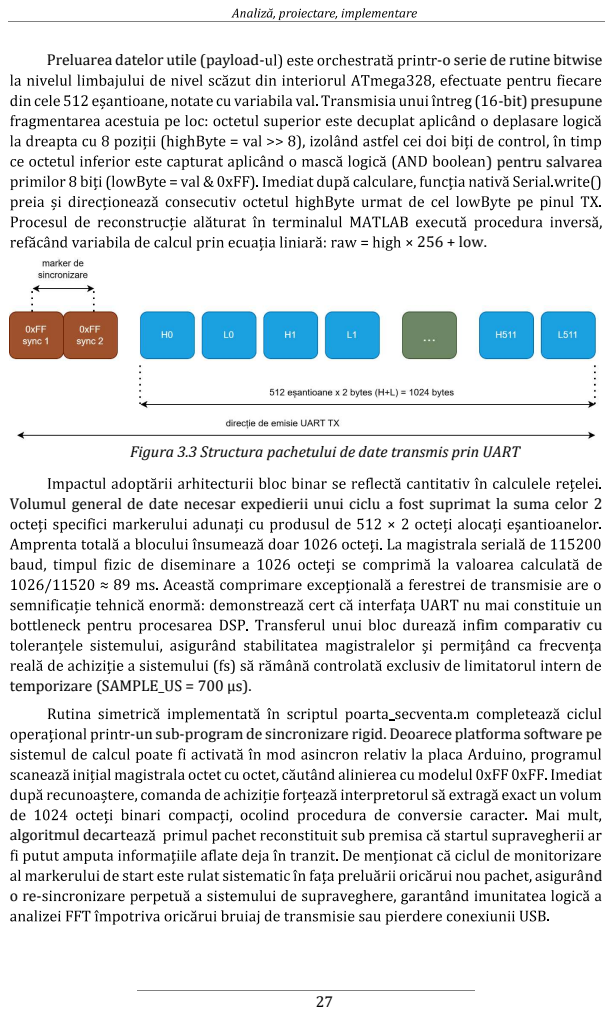
[picture p49: page 28]
Preluarea datelor utile (payload-; -o serie de rutine bitwise; -bit) presupune; ) pentru salvarea; 256 + low.; temporizare (SAMPLE_US = 700 µs).; algoritmul decart

Figura 3.3 Structura pachetului de date transmis prin UART

Volumul general de date necesar expedierii unui ciclu a fost suprimat la suma celor 2

fim comparativ cu

-un sub-program de sincronizare rigid. Deoarece platforma software pe

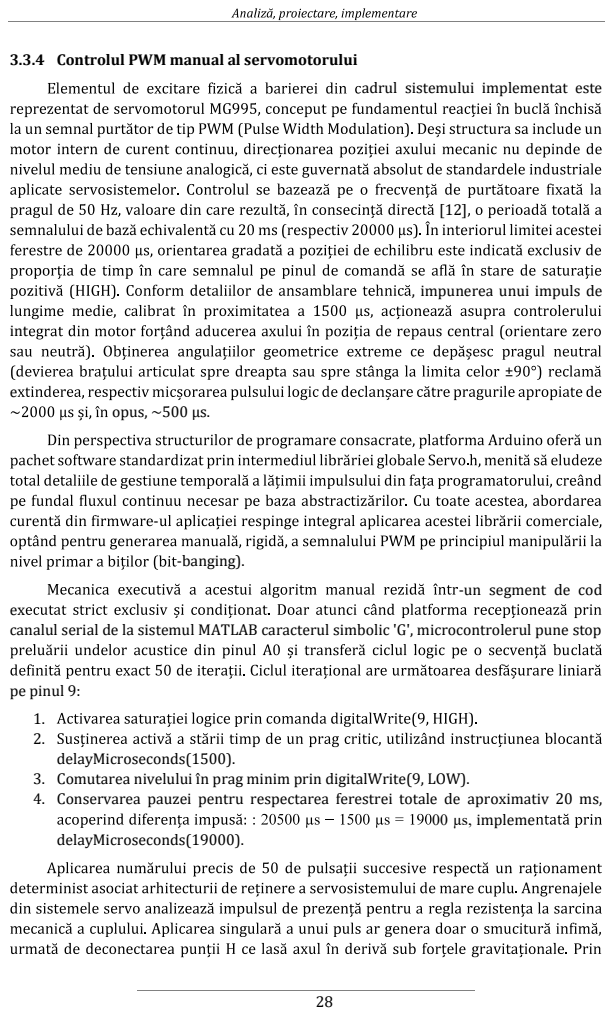
[picture p50: page 29]
int; opus, ~500 µs.; -banging).; 00 µs, impleme; delayMicroseconds(19000).

3.3.4 Controlul PWM manual al servomotorului

adrul sistemului implementat este

, impunerea unui impuls de

-un segment de cod

canalul serial de la sistemul MATLAB caracterul simbolic 'G', microcontrolerul pune stop

pe pinul 9:
delayMicroseconds(1500).
3. Comutarea nivelului în prag minim prin digitalWrite(9, LOW).
4. Conservarea pauzei pentru respectarea ferestrei totale de aproximativ 20 ms,

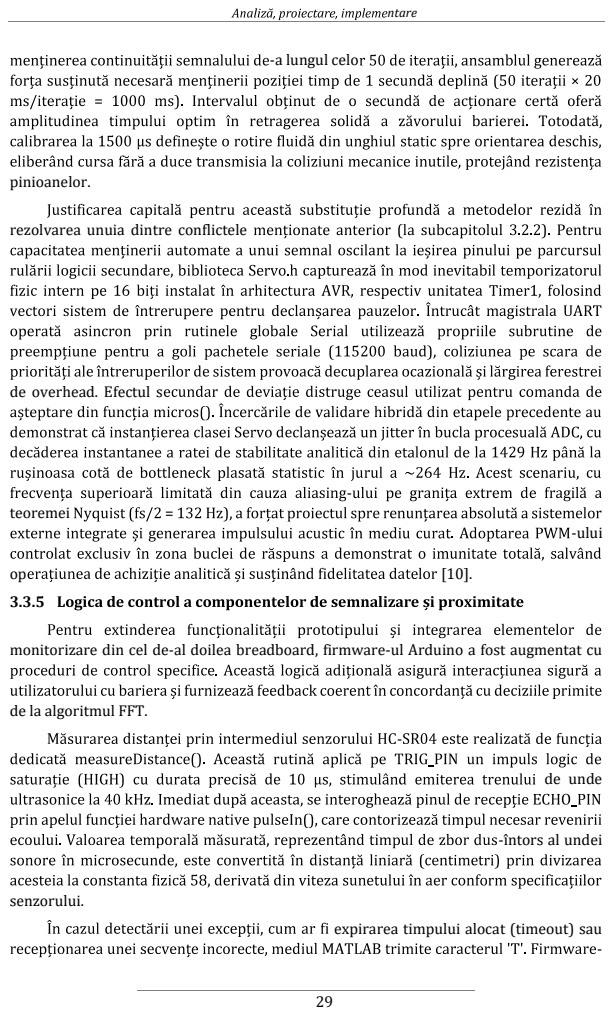
[picture p51: page 30]
ntare; -a lungul celo; pinioanelor.; - teoremei; -ului; de la algoritmul FFT.; de unde; senzorului.

rezolvarea unuia dintre conflictele

de overhead. Efectul s

monitorizare din cel de-al doilea breadboard, firmware-ul Arduino a fost augmentat cu

-întors al undei

expirarea timpului alocat (timeout) sau -

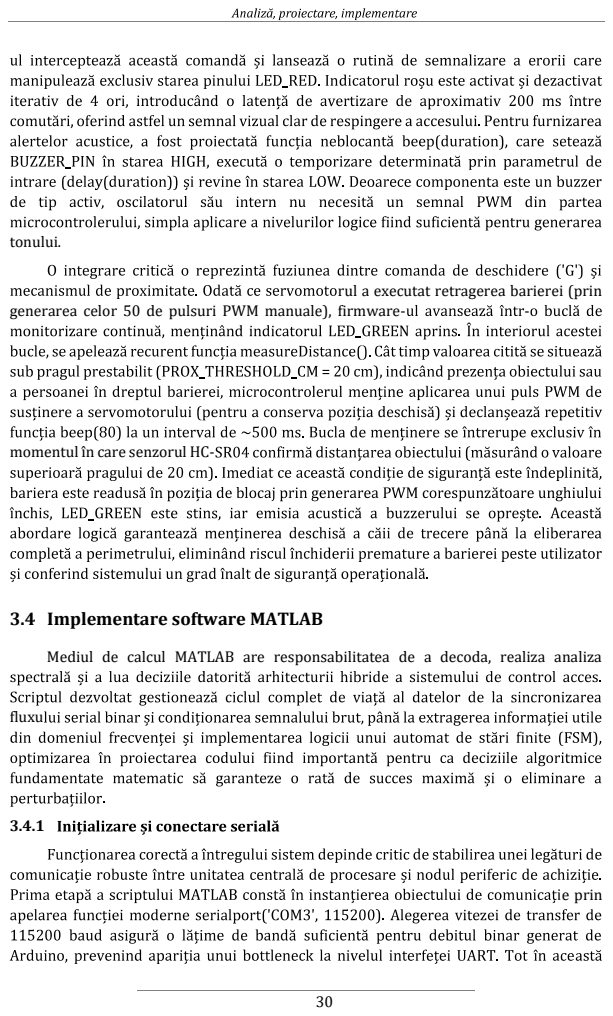
[picture p52: page 31]
tonului.; generarea celor 50 de pulsuri PWM manuale), firmware-; - momentul în care senzorul HC-; fluxu; e prin

rul a executat retragerea barierei (prin

3.4 Implementare software MATLAB

Mediul de calcul MATLAB are responsabilitatea de a decoda, realiza analiza

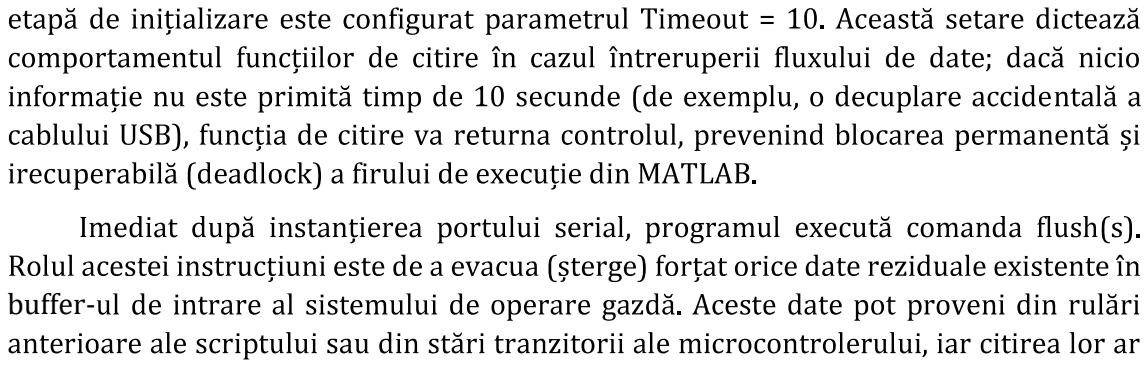
[picture p53: figure]
buffer-
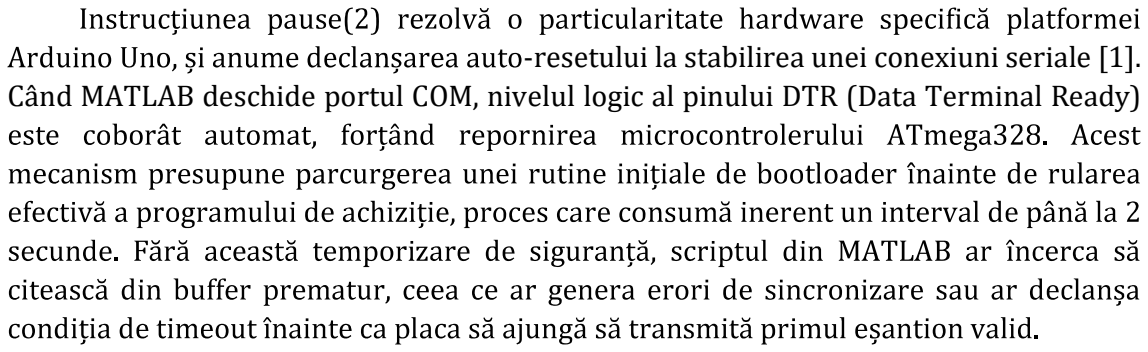
[picture p54: figure]
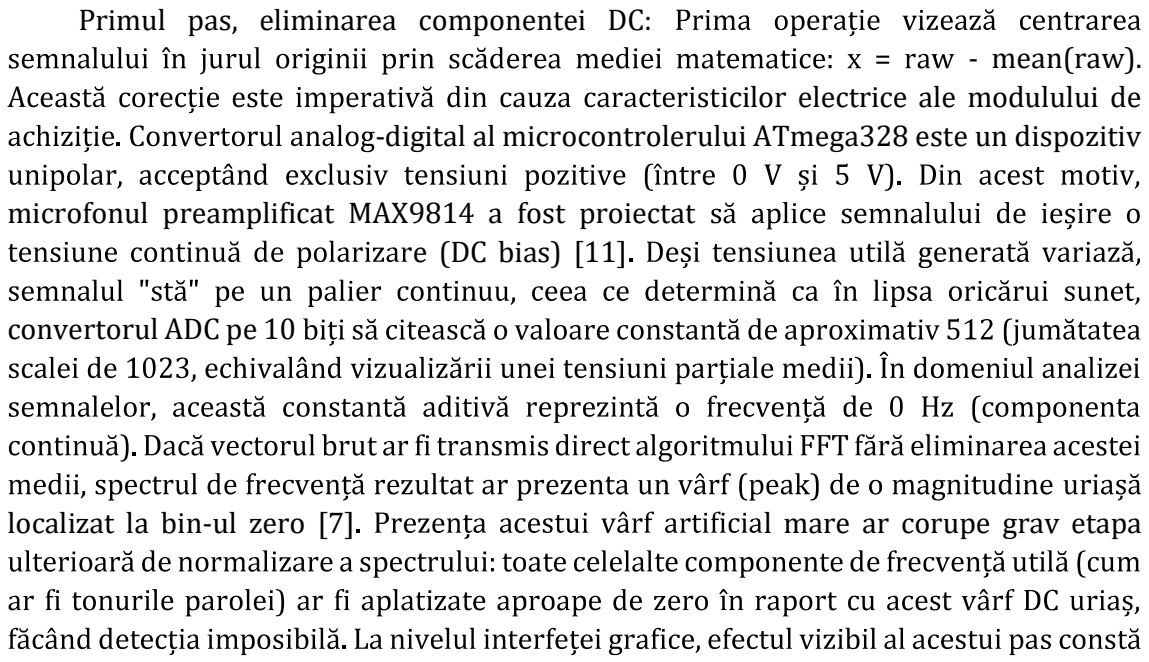
[picture p55: figure]
Primul pas, eliminarea componentei DC:; - mean(raw). icilor electrice ale modulului de; e (DC bias) [11]; convertorul ADC pe 10

31

corupe procesul de sincronizare a cadrelor binare.

-resetului la stabilirea unei conexiuni seriale [1]. Când MATLAB deschide portul COM, nivelul logic al pinului DTR (Data Terminal Ready)

### 3.4.2 Pipeline de procesare a semnalului

raw. În a
anomalii induse de mediul electronic. Pentru a extrage spectrul pur al semnalului,
vectorul raw este trecut printr- | it

-digital al microcontrolerului ATmega328 este un dispozitiv

microfonul preamplificat MAX9814 a fost proiectat

localizat la bin-ul zero [7] | l mare ar corupe grav etapa

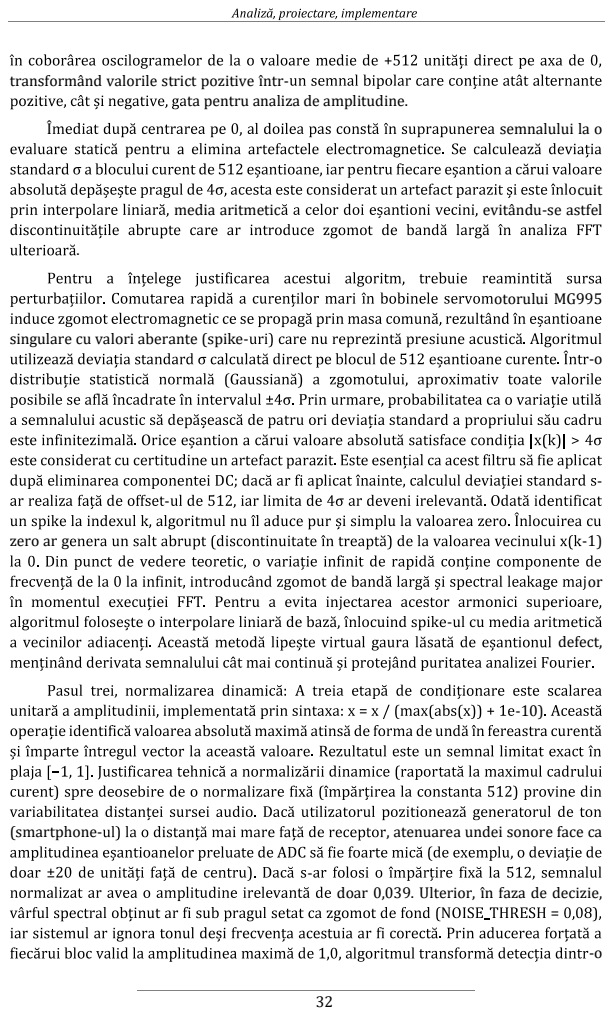
[picture p56: page 33]
semnalului la o; cuit; media aritmetic; evitându-se astfel; otorului MG995; - zero ar g; defect,; (smartphone-; , atenuarea undei sonore face ca -

transformând valorile strict pozitive într-

ta pentru analiza de amplitudine.

singulare cu valori aberante (spike-

doar 0,039. Ulterior, în faza de decizie,

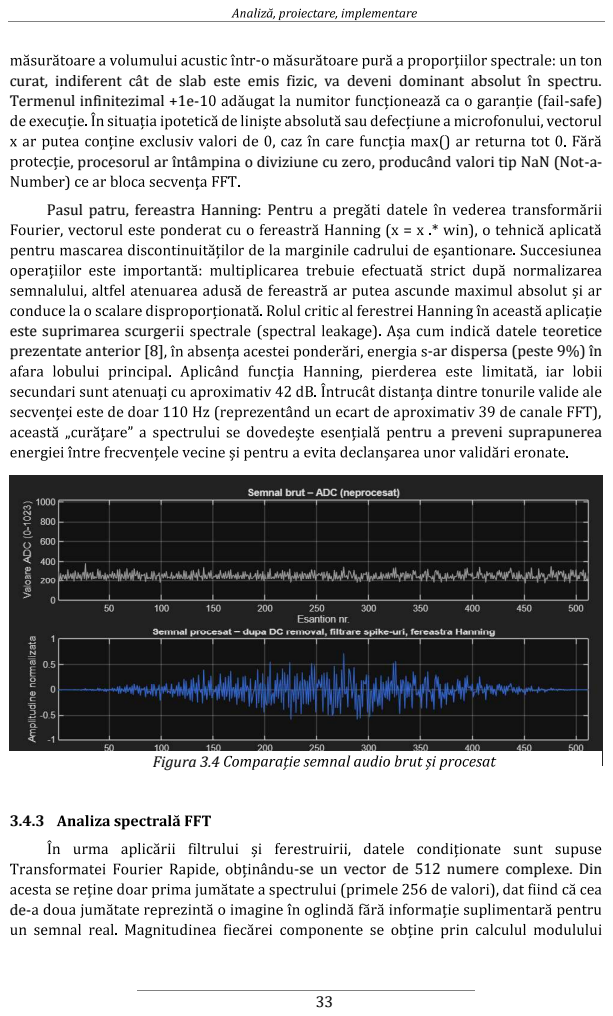
[picture p57: page 34]
Termenul infinitezimal +1e-; -safe); este suprimarea scurger; eoretice; prezentate anterior [8]; -ar dispersa (peste 9%) în; Figura 3.4

- curat, indiferent cât de slab este emis fizic, va deveni dominant absolut în spectru.

ie, procesorul ar întâmpina o diviziune cu zero, producând valori tip NaN (Not-a-

Pasul patru, fereastra Hanning: Pentr

tru a preveni suprapunerea

-se un vector de 512 numere complexe. Din

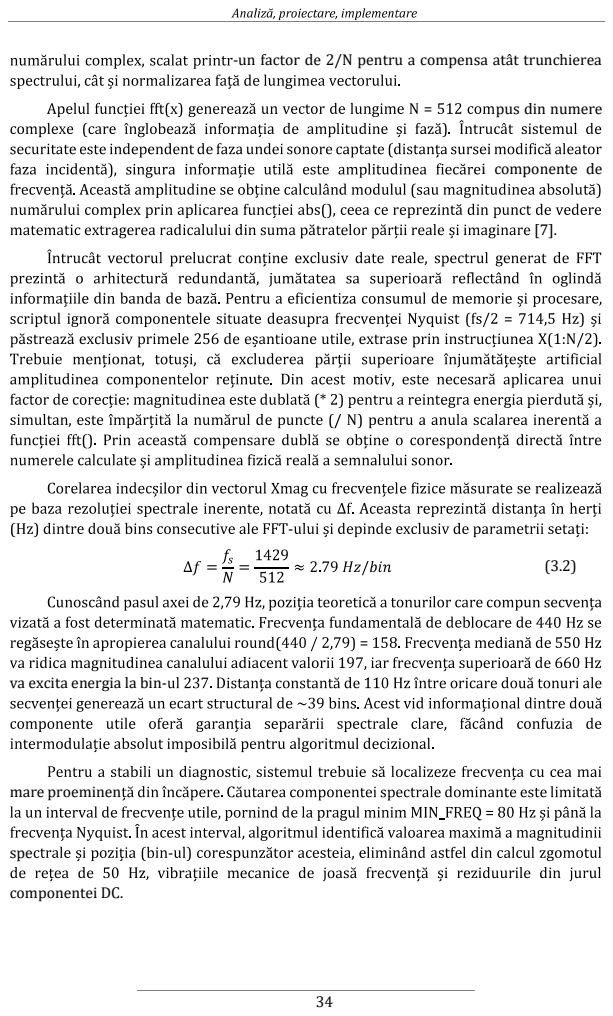
[picture p58: page 35]
i componente de; mare proeminen; spe; - componentei DC.

-un factor de 2/N pentru a compensa atât trunchierea

pus din numere

va excita energia la bin-

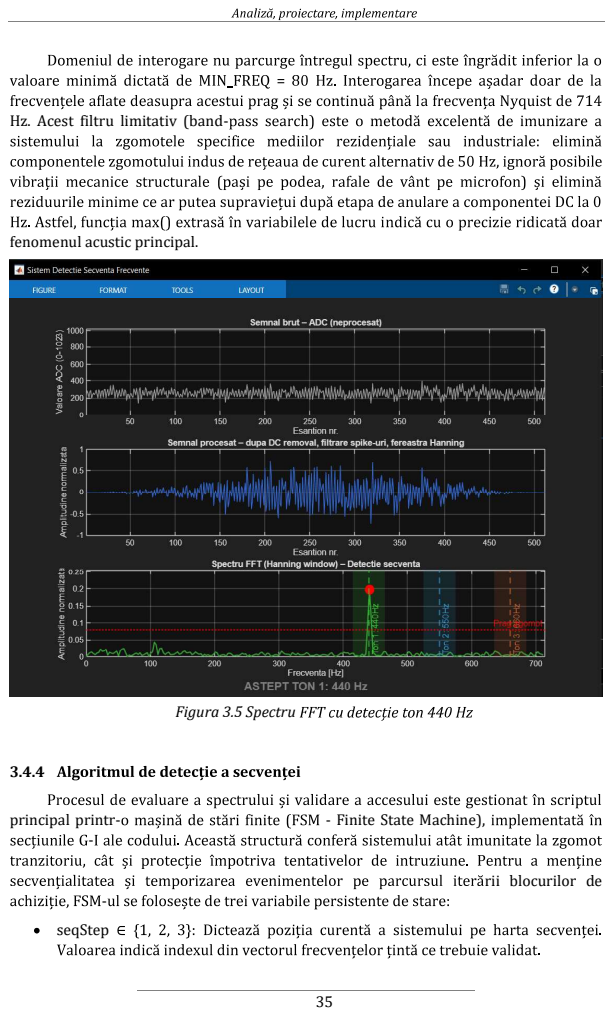
[picture p59: page 36]
principal printr-; - Finite State Machine), -; rii blocurilor de - seqStep; Figura 3.5 Spectru

Hz. Acest filtru limitativ (band-

fenomenul acustic principal.

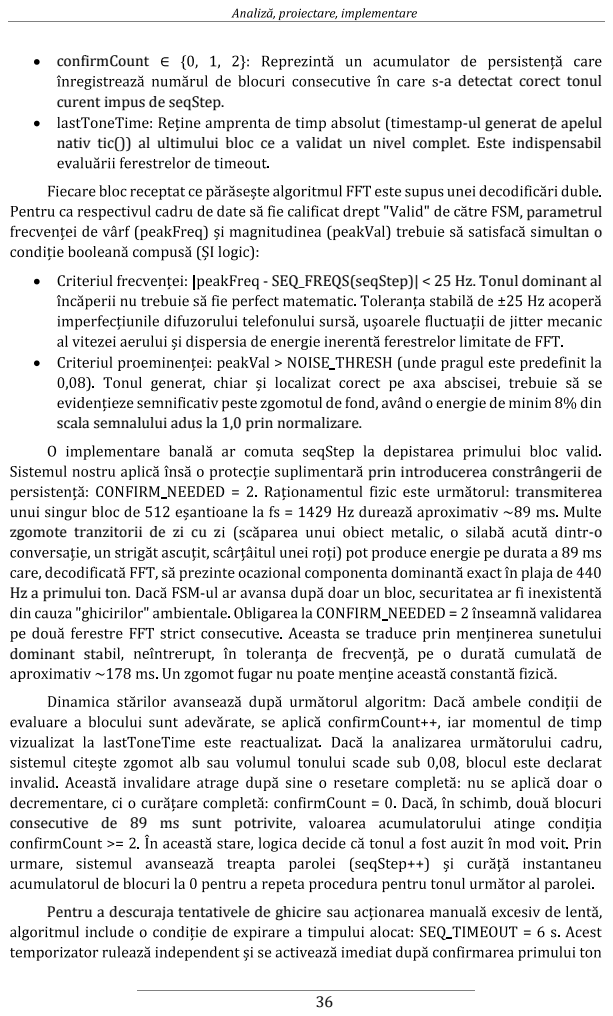
[picture p60: page 37]
confirmCount; , parametrul imultan o; : transmiterea; zgomote tranzitorii de zi cu z; Hz a primului ton.; - dominant sta

-a detectat corect tonul

curent impus de seqStep.

-ul generat de apelul

nativ tic()) al ultimului bloc ce a validat un nivel complet. Este indispensabil

- SEQ_FREQS(seqStep)| < 25 Hz. Tonul dominant al

scala semnalului adus la 1,0 prin normalizare.

prin introducerea constrângerii de

consecutive de 89 ms sunt potrivite

Pentru a descuraja tentativele de ghicire

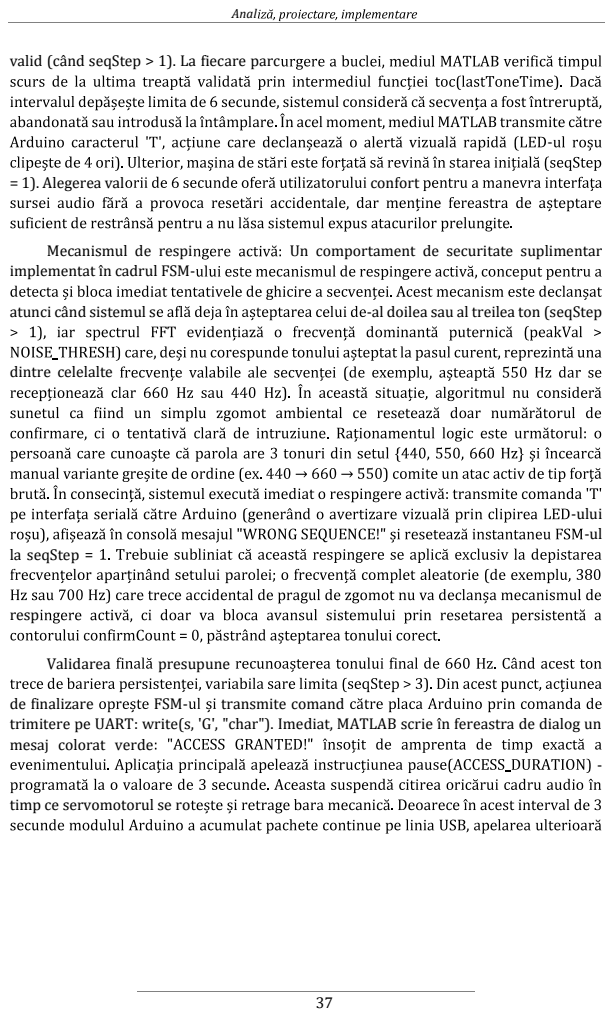
[picture p61: page 38]
Anal; - = 1). Alegerea val; confort; Mecanismul de respi; Un comportament de securitate suplimentar; atunci când sistemul s; -al doilea sau al treilea ton (seqStep; dintre celelalte; -ului -ul; la seqStep; resp; Validarea; presupune; de finalizare; FSM-; transmite comand

valid (când seqStep > 1). La fiecare parc

implementat în cadrul FSM-

trimitere pe UART: write(s, 'G', "char"). Imediat, MATLAB scrie în fereastra de dialog un
mesaj colorat verde
- timp ce servomotorul se ro

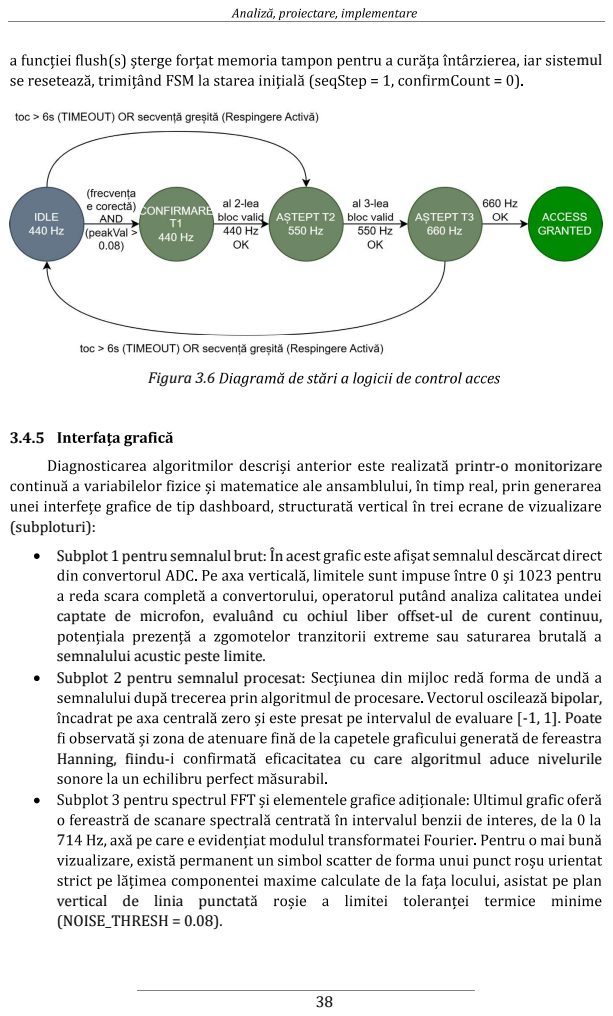
[picture p62: page 39]
mul; printr-o monitorizare; bipolar, -1, 1]. Poate; Hanning, fiindu-; tatea cu care algoritmul aduce nivelurile; Figura 3.6

(subploturi):
Subplot 1 pentru semnalul brut: În ac

captate de microfon, evaluând cu ochiul liber offset-ul de curent continuu,

semnalului acustic peste limite.
Subplot 2 pentru semnalul procesat:

vertical de linia punctat
(NOISE_THRESH = 0.08).

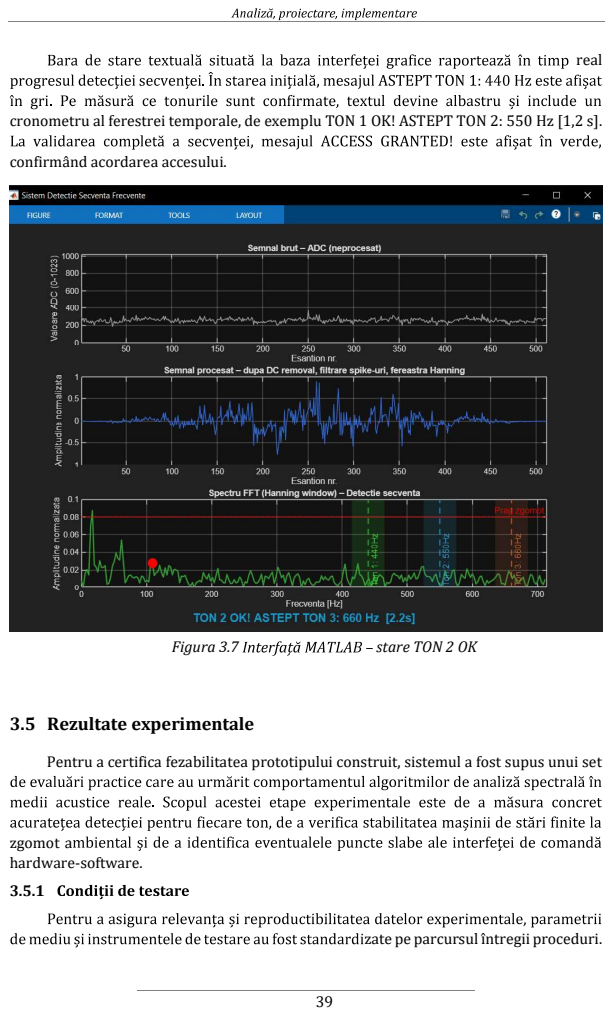
[picture p63: page 40]
real; 3.5 Rezultate experimentale; zgomot a hardware-software.; Figura 3.7; stare TON 2 OK

cronometru al ferestrei temporale, de exemplu TON 1 OK! ASTEPT TON 2: 550 Hz [1,2 s].

confirmând acordarea accesului.

Pentru a certifica fezabilitatea prototipului construit, sistemul a fost supus unui set

zate pe parcursul întregii proceduri.

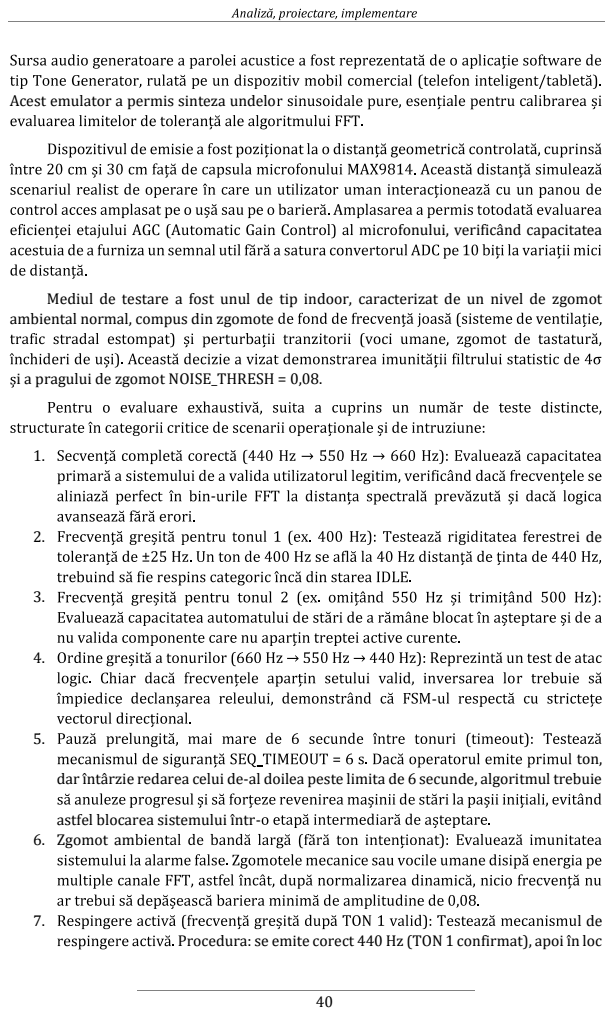
[picture p64: page 41]
ton,

Acest emulator a permis sinteza undelo

fonului, verificând capacitatea

Mediul de testare a fost unul de tip indoor, caracterizat de un nivel de zgomot
ambiental normal, compus din zgomote

i a pragului de zgomot NOISE_THRESH = 0,08.

dar întârzie redarea celui de-al doilea peste limita de 6 secunde, algoritmul trebuie

astfel blocarea sistemului într-
6. Zgomot am

Procedura: se emite corect 440 Hz (TON 1 confirmat), apoi în loc

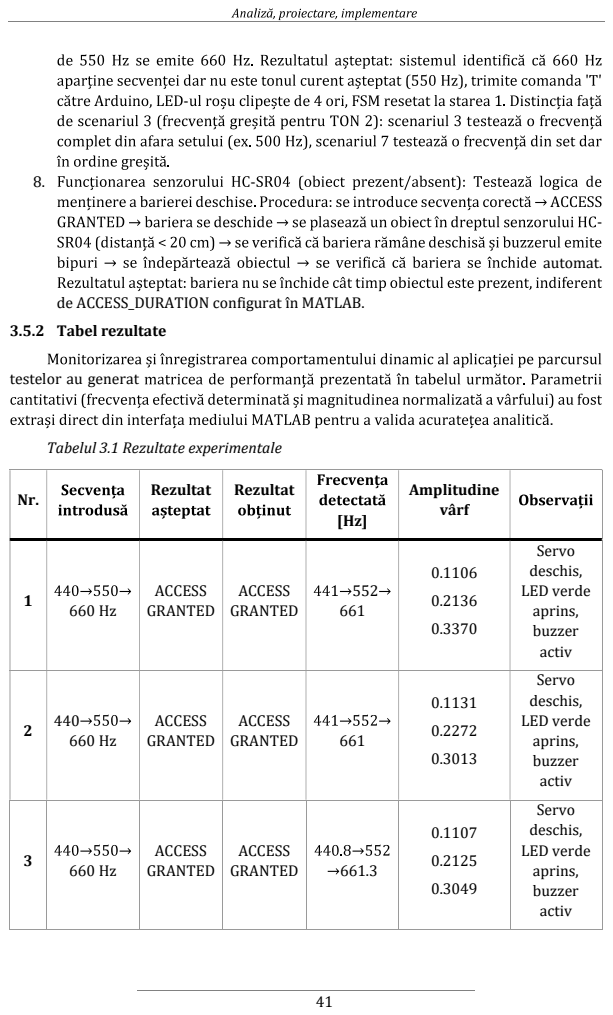
[picture p65: page 42]
automat.

de ACCESS_DURATION configurat în MATLAB.
3.5.2 Tabel rezultate

testelor au generat

. Tabelul 3.1 Rezultate experimentale

Nr. | | Rezultat | Rezultat | [Hz] | Amplitudine vârf

1 | 660 Hz | ACCESS GRANTED | ACCESS GRANTED | 552 661 | 0.1106 0.2136 0.3370 | Servo deschis, LED verde aprins, buzzer activ

2 | 440 660 Hz | ACCESS GRANTED | ACCESS GRANTED | 661 | 0.1131 0.2272 0.3013 | Servo deschis, LED verde aprins, buzzer activ

3 | 660 Hz | ACCESS GRANTED | ACCESS GRANTED | 661.3 | 0.1107 0.2125 0.3049 | Servo deschis, LED verde aprins, buzzer activ

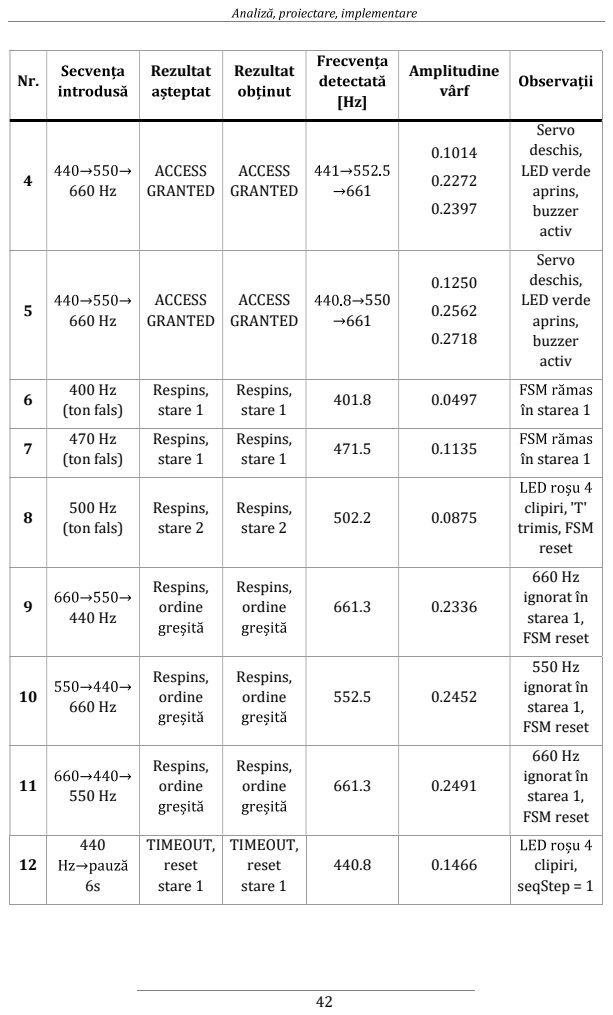
[picture p66: page 43]

Nr. | | Rezultat | Rezultat | [Hz] | Amplitudine vârf

4 | 660 Hz | ACCESS GRANTED | ACCESS GRANTED | 661 | 0.1014 0.2272 0.2397 | Servo deschis, LED verde aprins, buzzer activ

5 | 660 Hz | ACCESS GRANTED | ACCESS GRANTED | 550 661 | 0.1250 0.2562 0.2718 | Servo deschis, LED verde aprins, buzzer activ

6 | 400 Hz (ton fals) | Respins, stare 1 | Respins, stare 1 | 401.8 | 0.0497 | în starea 1

7 | 470 Hz (ton fals) | Respins, stare 1 | Respins, stare 1 | 471.5 | 0.1135 | în starea 1

8 | 500 Hz (ton fals) | Respins, stare 2 | Respins, stare 2 | 502.2 | 0.0875 | clipiri, 'T' trimis, FSM reset

9 | 440 Hz | Respins, ordine | Respins, ordine | 661.3 | 0.2336 | 660 Hz ignorat în starea 1, FSM reset

10 660 Hz | | Respins, ordine | Respins, ordine | 552.5 | 0.2452 | 550 Hz ignorat în starea 1, FSM reset

11 550 Hz | | Respins, ordine | Respins, ordine | 661.3 | 0.2491 | 660 Hz ignorat în starea 1, FSM reset

12 | 440 6s | TIMEOUT, reset stare 1 | TIMEOUT, reset stare 1 | 440.8 | 0.1466 | clipiri, seqStep = 1

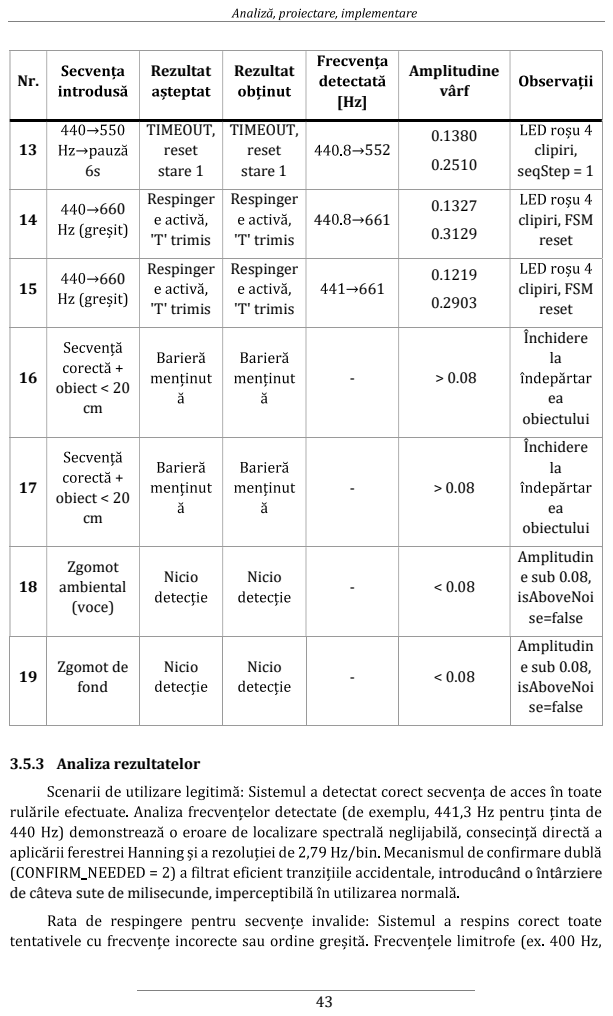
[picture p67: page 44]
3.5.3 Analiza rezultatelor; introducând o întârziere

Nr. | | Rezultat | Rezultat | [Hz] | Amplitudine vârf

13 | 6s | TIMEOUT, reset stare 1 | TIMEOUT, reset stare 1 | 552 | 0.1380 0.2510 clipiri, | seqStep = 1

14 | 660 | Respinger 'T' trimis | Respinger 'T' trimis | 44 661 | 0.1327 0.3129 | clipiri, FSM reset

15 | 660 | Respinger 'T' trimis | Respinger 'T' trimis | 661 | 0.1219 0.2903 clipiri, FSM | reset

16 obiect < 20 | cm | | | - > 0.08 | | Închidere la ea obiectului

17 obiect < 20 | cm | | | - > 0.08 | | Închidere la ea obiectului

18 | Zgomot ambiental (voce) | Nicio | Nicio | - | < 0.08 | Amplitudin e sub 0.08, isAboveNoi se=false

19 Zgomot de | fond | Nicio | Nicio | - | < 0.08 | Amplitudin e sub 0.08, isAboveNoi se=false

de câteva sute de milisecunde, imperc

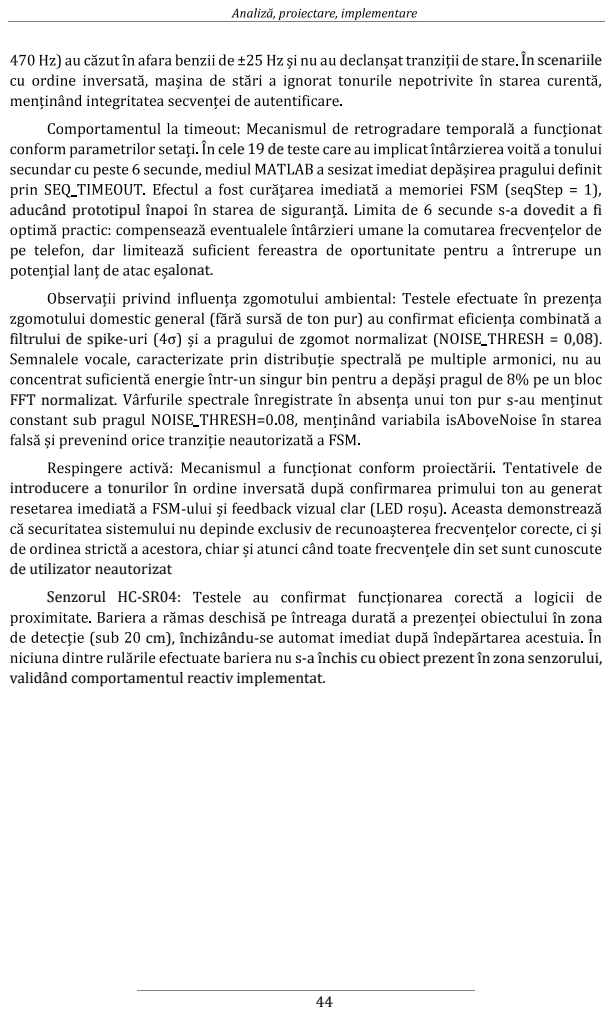
[picture p68: page 45]
În scenariile; ele 19 de; aducând prototipul înapoi; -a dovedit a fi; alonat.; filtrului de spike-; 0,08). - FFT normalizat.; Senzorul HC-SR04:; în zona; cm), închizându-

introducere a tonurilor în - de utilizator neautorizat

-a închis cu obiect prezent în zona senzorului,

validând comportamentul reactiv implementat.

Concluzii

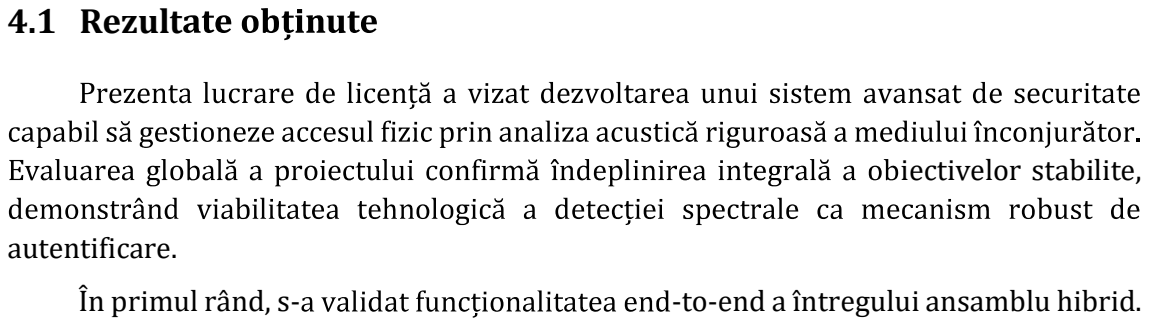
[picture p69: figure]
4.1 Rezult; iectivelor stabilite,; autentificare.; În primul rând, s-; -to-end a întregului ansamblu hibrid.
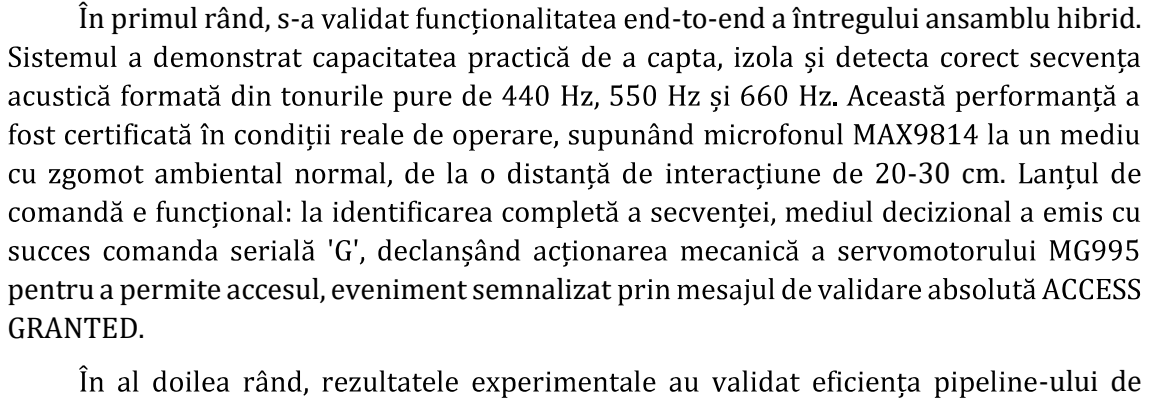
[picture p70: figure]
GRANTED.; -ului de
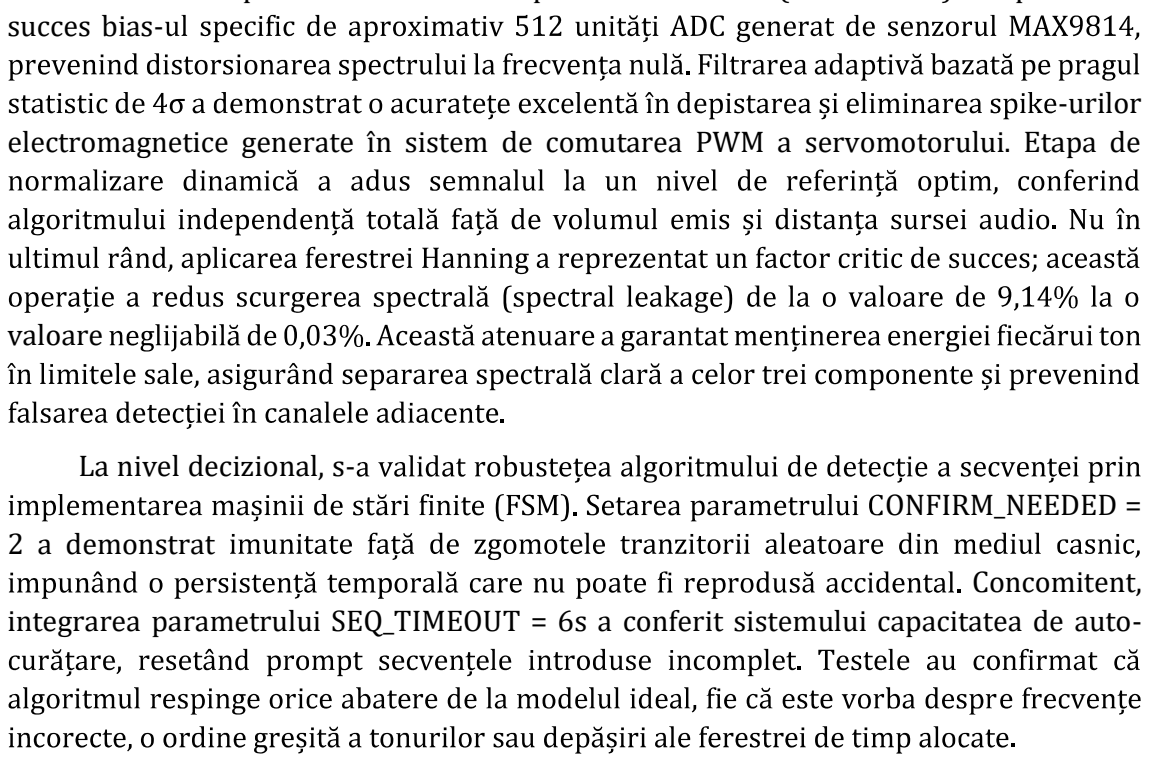
[picture p71: figure]
succes bias-; -urilor; valoare; La nivel decizional, s-; ONFIRM_NEEDED =; 2 a demonstrat; Concomitent,

45

# 4 Concluzii

pentru a permite accesul, eveniment semnalizat

procesare a semnalului digital, demonstrând complementaritatea celor patru etape fundamentale. Etapa de eliminare a componentei continue (DC removal) a suprimat cu

electromagnetice generate în sistem de comutarea PWM a servomotorului. Etapa de

integrarea parametrului SEQ_TIMEOUT = 6s a conferit sistemului capacitatea de auto-

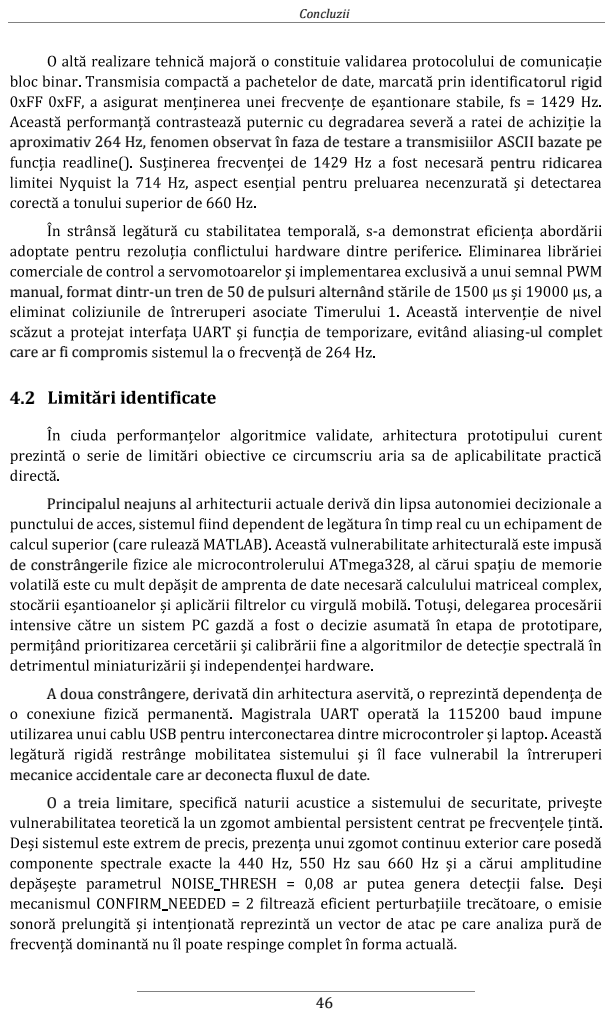
[picture p72: page 47]
Concluzii; torul rigid; pentru ridicarea - manual, format dintr-un tren de 50 de pulsuri alternând s; -ul complet; de constrânger

aproximativ 264 Hz, fenomen observat în faza de testare a transmisiilor ASCII bazate pe

care ar fi compromis

Principalul neajuns al

A doua constrângere, der

mecanice accidentale care ar deconecta fluxul de date.
O a treia limitare,

Concluzii

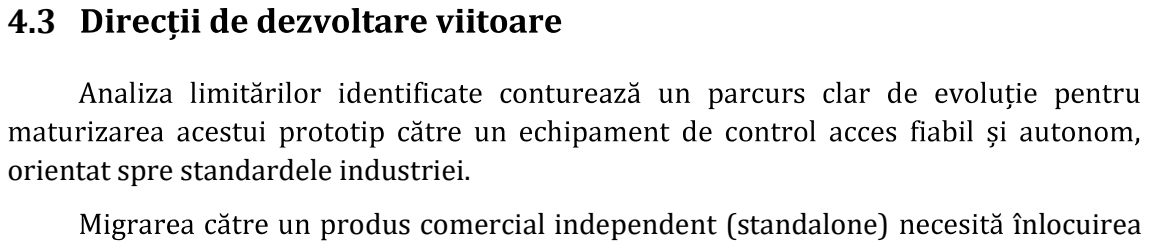
[picture p73: figure]
orientat spre standardele industriei.; rodus comercial independent (standalone); înlocuirea
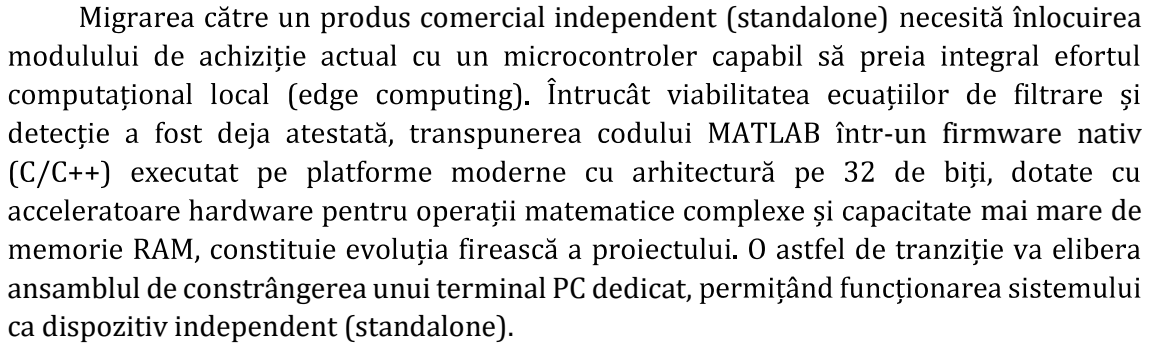
[picture p74: figure]
-un firmware nativ; mai mare de; ca dispozitiv independent (standalone).
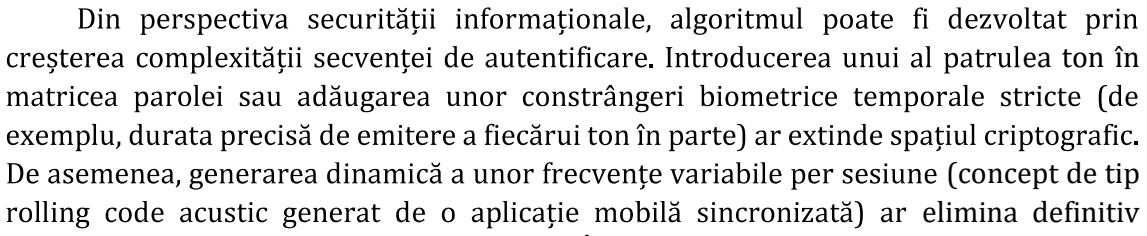
[picture p75: figure]
ea ton în; (concept de tip elimina definitiv

47

ansamblul de constrângerea unui terminal PC dedicat,

eliminarea conexiunii fizice USB. Trecerea transferului de date, a logurilor de acces sau a utilizând protocoale de tip Bluetooth Low Energy (BLE) sau standarde WiFi ar conferi sistemului o ind

posibilitatea unui atac prin reînregistrare. În scenariile de operare din medii intens

parametrului CONFIRM_NEEDED de la 2 la o valoare mai mare, - ce obiectul a tranzitat perimetrul, conferind sistemului un comportament reactiv la

# 5 Bibliografie

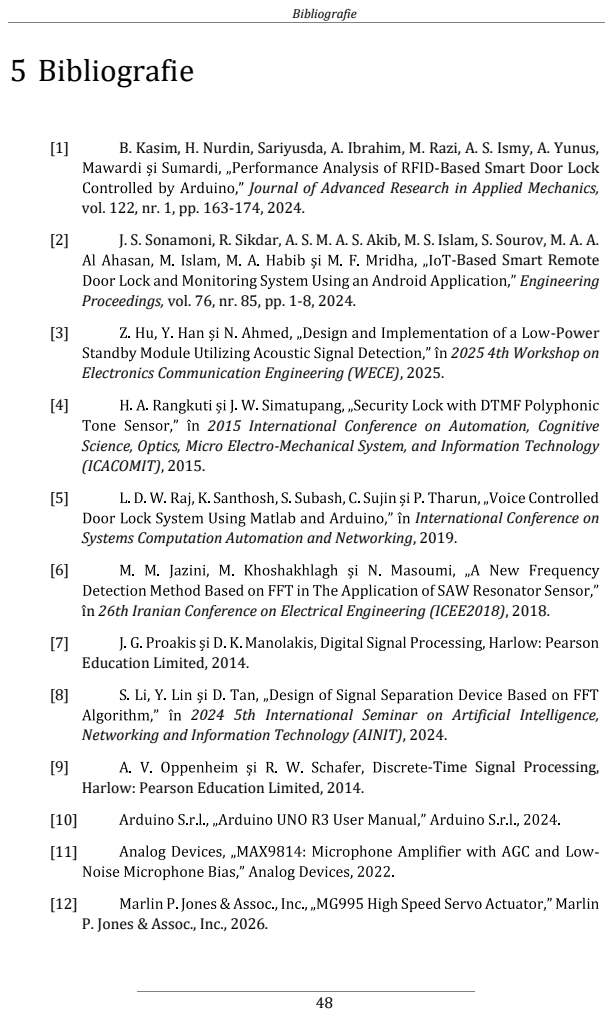
[picture p76: page 49]
Bibliografie; Engineering; 2025 4th Workshop on

[1] B. Kasim, H. Nurdin, Sariyusda, A. Ibrahim, M. Razi, A. S. Ismy, A. Yunus, -Based Smart Door Lock

Journal of Advanced Research in Applied Mechanics,

vol. 122, nr. 1, pp. 163-174, 2024.
[2] J. S. Sonamoni, R. Sikdar, A. S. M. A. S. Akib, M. S. Islam, S. Sourov, M. A. A. -Based Smart Remote

Proceedings, vol. 76, nr. 85, pp. 1-8, 2024.
[3] -Power

Electronics Communication Engineering (WECE), 2025.

2015 International Conference on Automation, Cognitive

Science, Optics, Micro Electro-Mechanical System, and Information Technology
(ICACOMIT), 2015.

International Conference on

Systems Computation Automation and Networking, 2019.

în 26th Iranian Conference on Electrical Engineering (ICEE2018), 2018.
Education Limited, 2014.

2024 5th International Seminar on Artificial Intelligence,

Networking and Information Technology (AINIT), 2024.
[9] -Time Signal Processing,
Harlow: Pearson Education Limited, 2014.

P. Jones & Assoc., Inc., 2026.

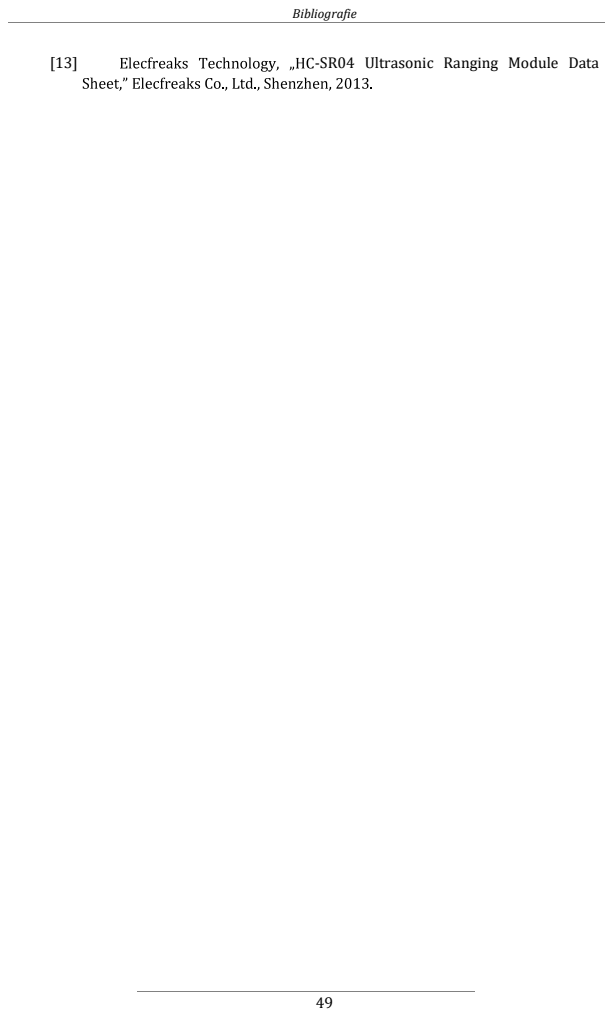
[picture p77: page 50]
Bibliografie

[13] -SR04 Ultrasonic Ranging Module Data
